Gigahawk/pipod_hw/analysis/usb_differential_impedance.md

# Differential Impedance Calculation for USB Data Signal

Values based on a standard 0.8mm 4 layer board from PCBWay (2116 PrePreg):
https://www.pcbway.com/multi-layer-laminated-structure.html

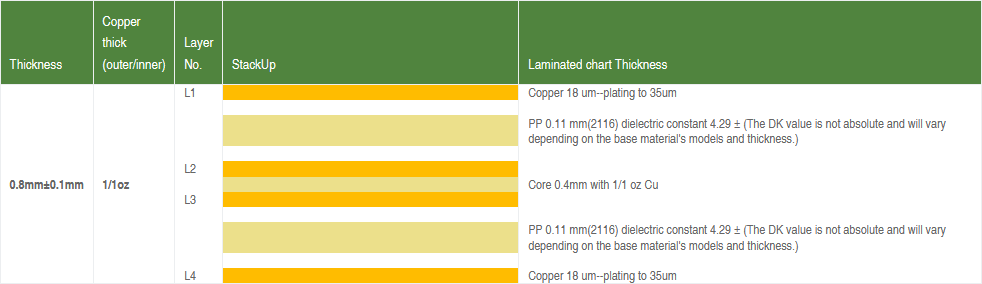
[picture p2: analysis/images/pcbway_stackup.png]
pcbway_stackup


Calculation done using KiCad's impedance caclculator:
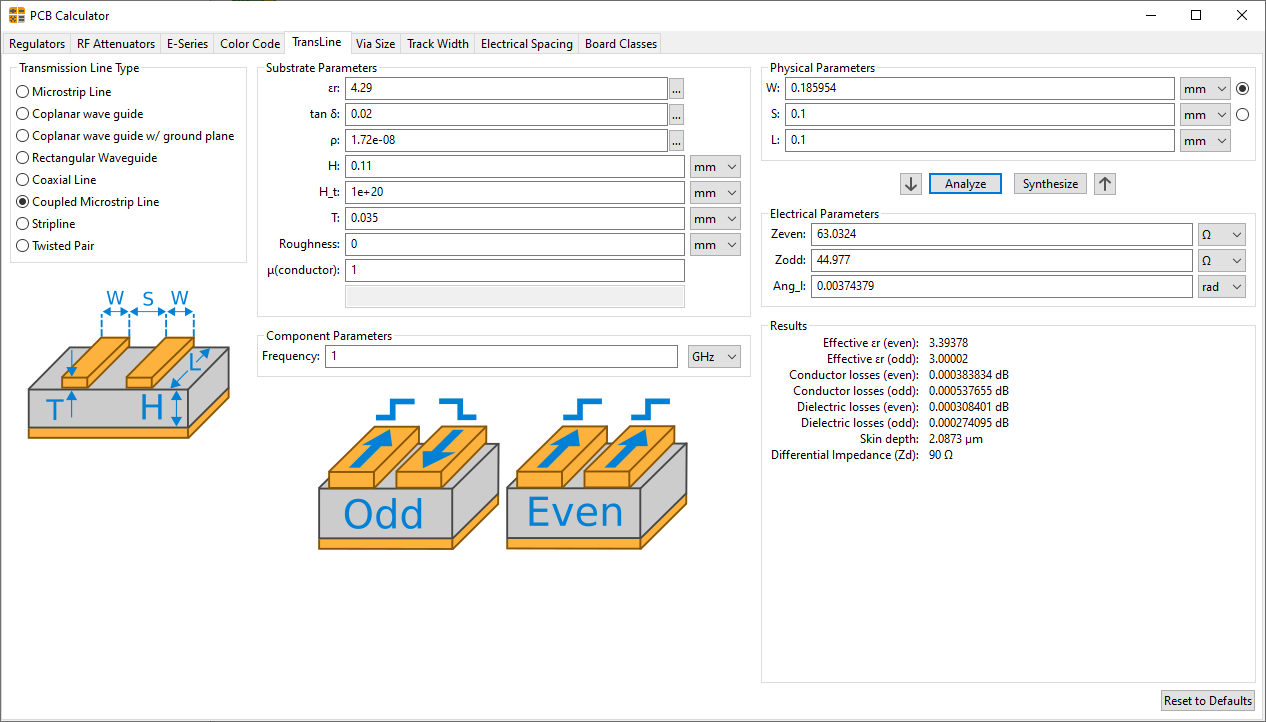
[picture p3: analysis/images/usb_diff_calc_0.1mm_gap.png]
usb_diff_calculations

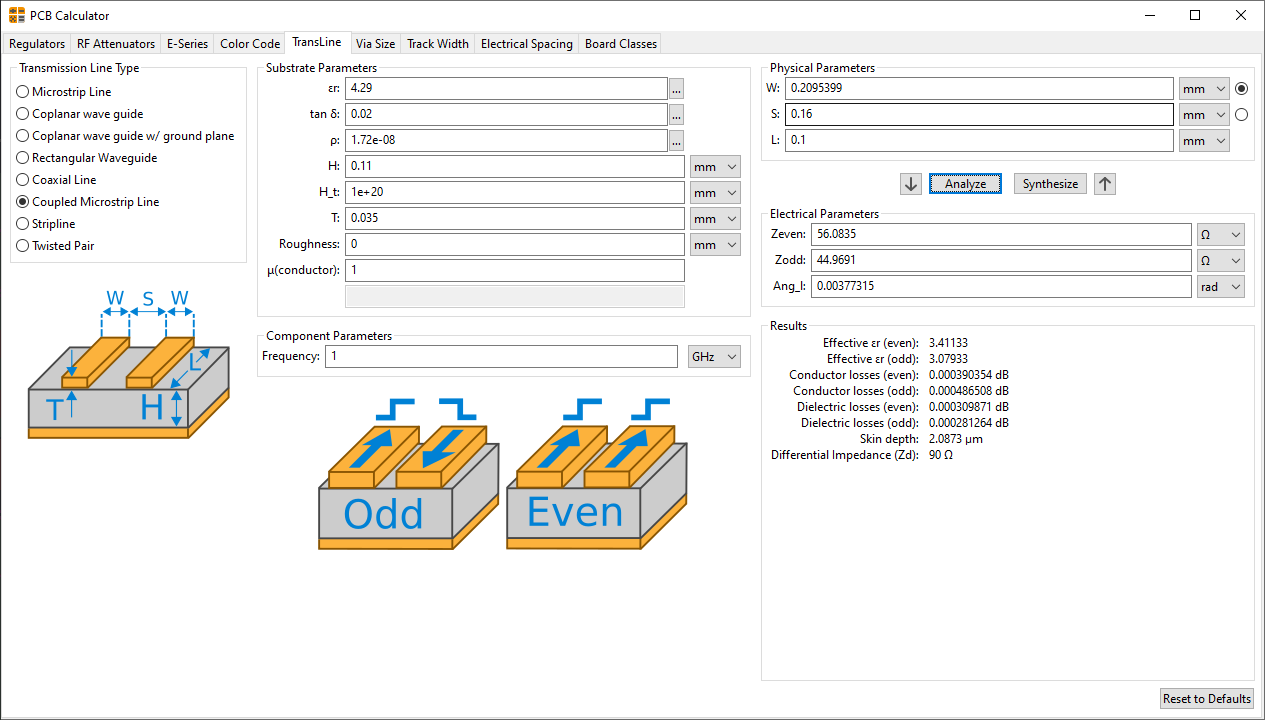
[picture p4: analysis/images/usb_diff_calc_0.16mm_gap.png]
usb_diff_calculations

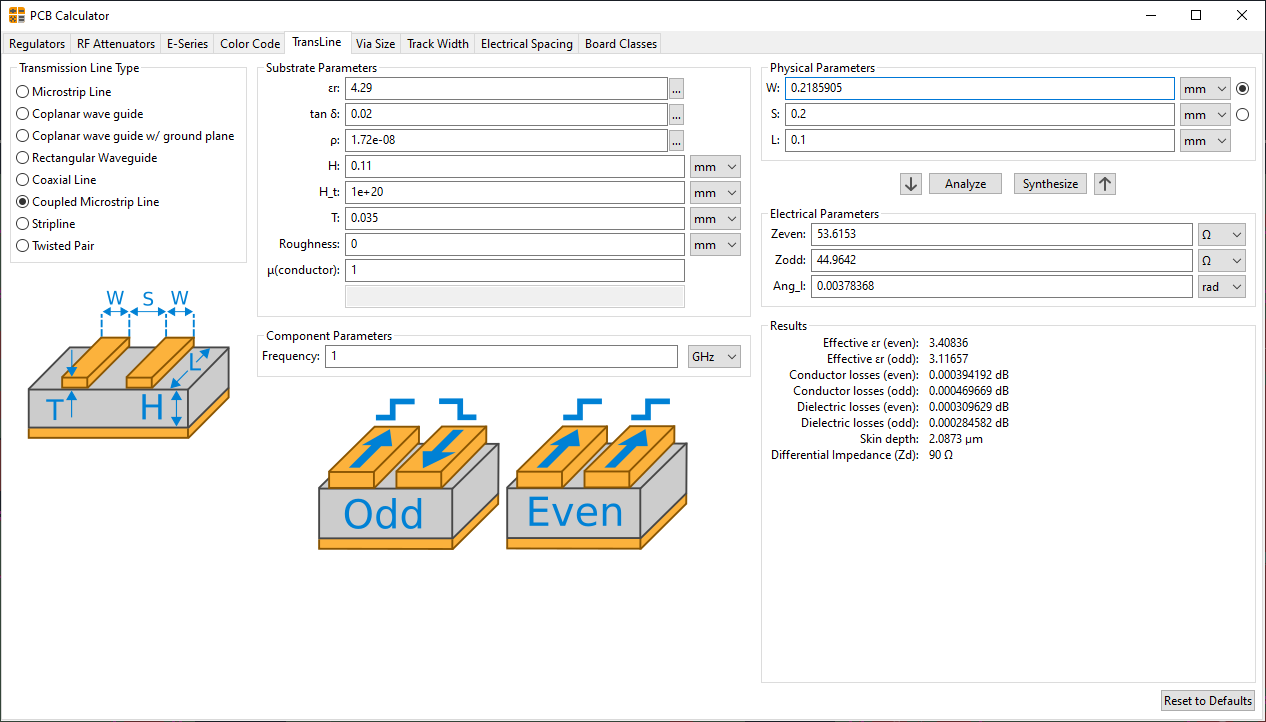
[picture p5: analysis/images/usb_diff_calc_0.2mm_gap.png]
usb_diff_calculations
