Gigahawk/pipod_hw/analysis/vendors.md

# PCB Vendors

While JLCPCB would be preferred for being really cheap, they only allow sourcing parts from LCSC for assembly.
This significantly limits our design freedom.

Instead, we will use PCBWay, since their assembly service allows sourcing parts from anywhere.
