Gigahawk/pipod_hw/(threads)

Thread 1 (2022-09-09):

Display

jaksatomovic, 2022-09-09:
What kind of display do you plan to use. Is it the ipod’s original or something else?

Gigahawk, 2022-09-21:
https://github.com/Gigahawk/pipod_hw/blob/master/analysis/display_mux.md

Closed 2022-09-09.

Thread 3 (2023-02-07):

Random resistor on pi vcc enable?

Gigahawk, 2023-02-07:

Gigahawk, 2023-02-13:
This is probably there so the pi can latch its own power, need to figure out if that's actually implemented

Gigahawk, 2023-02-13:
Yea it's also connected to the gpio expander

Closed 2023-02-13.

Thread 4 (2023-02-07):

Digital pot for charge control?

Gigahawk, 2023-02-07:
Theoretically we can wire the CC lines to the ADC, but will probably have to use some diodes to join them to prevent shorting the lines together.

Need to check what sorts of voltages we expect on the CC lines

Thread 8 (2025-02-08):

Look into using a small MCU to generate mclk?

Gigahawk, 2025-02-08:

Gigahawk, 2025-03-11:
can probably also switch to cirrus logic CS43131, seems to have a integrated headphone driver so we can probably get rid of the separate amp too
