Gigahawk/pipod_hw/pipod_hw.kicad_pcb

## KiCad design pipod_hw.kicad_pcb (2022-12-23)

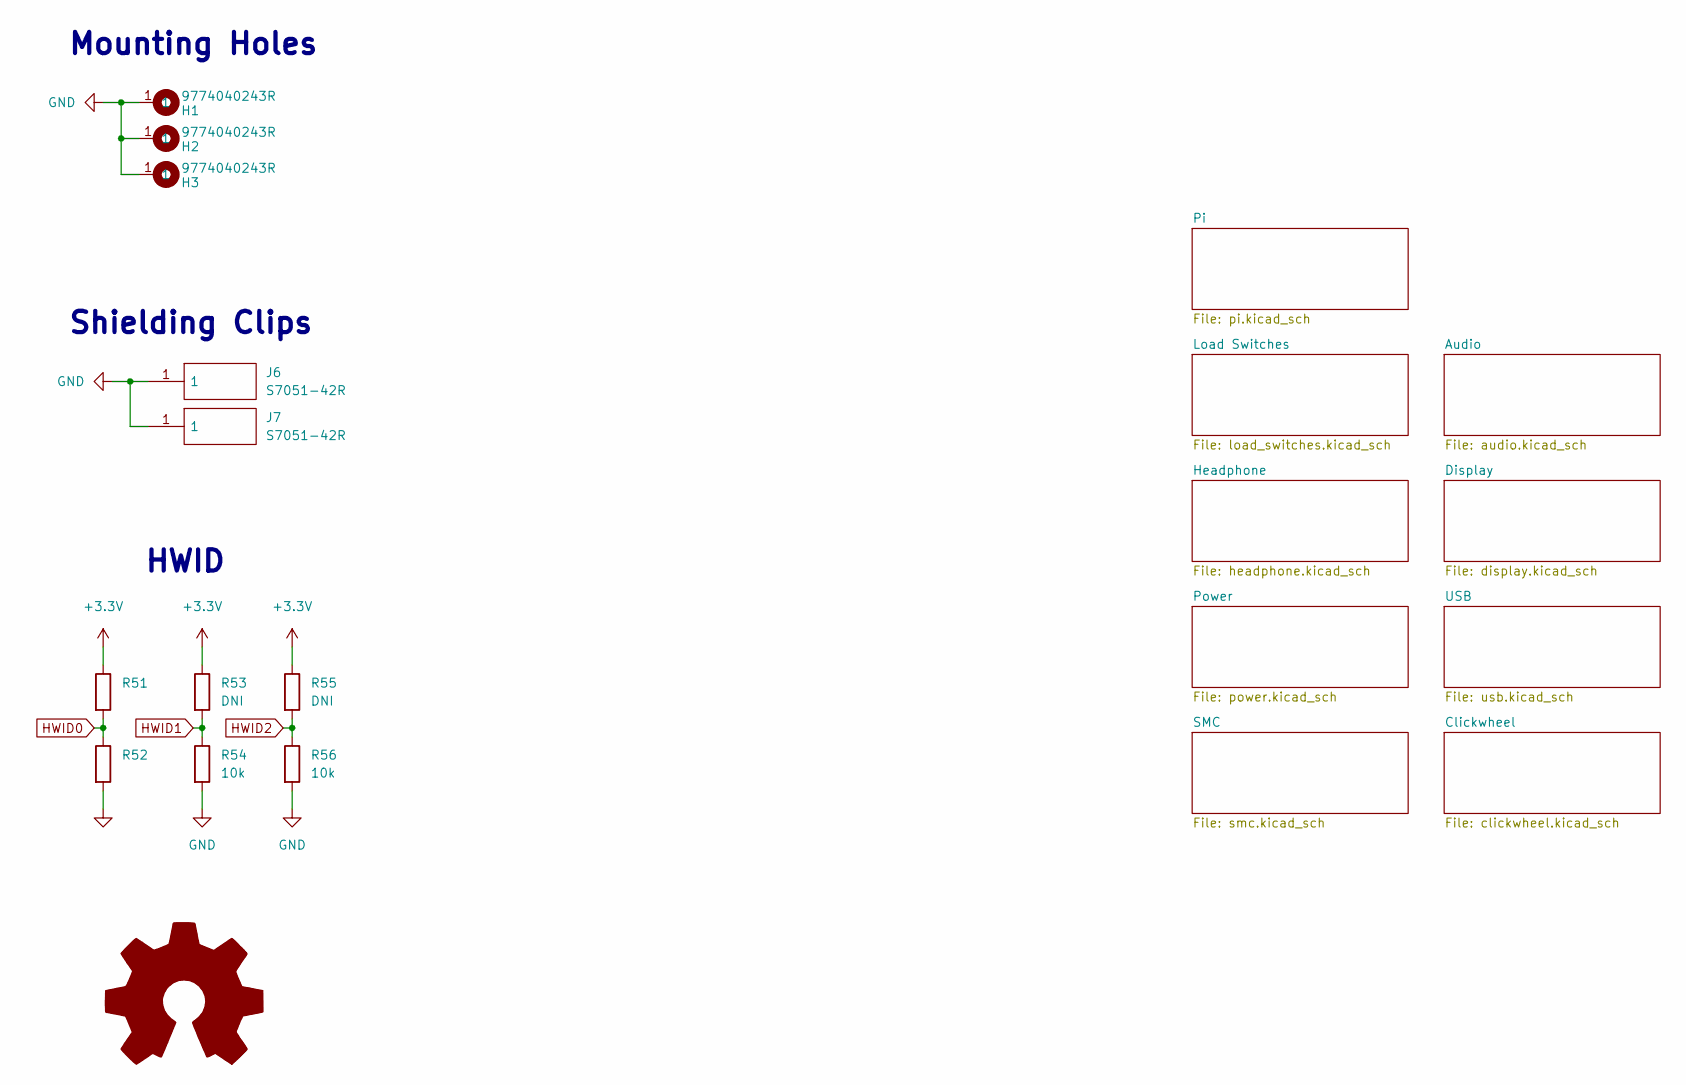
[picture p6: schematic pipod_hw.kicad_sch, piPod IO/SMC Board]

Parts:
H1, H2, H3: 9774040243R; Manufacturer Part 9774040243R; Digikey Part 732-7090-2-ND
J6, J7: S7051-42R; S705142R; Mouser Part 855-S7051-42R
LOGO1: Logo_Open_Hardware_Large; OSHW-Logo2_9.8x8mm_Mask
R51: R_0402_1005Metric
R52: (no value)
R53, R55: DNI; R_0402_1005Metric
R54, R56: 10k; R_0402_1005Metric

Connections:
+3V3: R51.1, R53.1, R55.1; also elsewhere on the board
HWID0: R51.2, R52.1; also elsewhere on the board
HWID1: R53.2, R54.1; also elsewhere on the board
HWID2: R55.2, R56.1; also elsewhere on the board

Notes on the sheet:
Mounting Holes
HWID
Shielding Clips

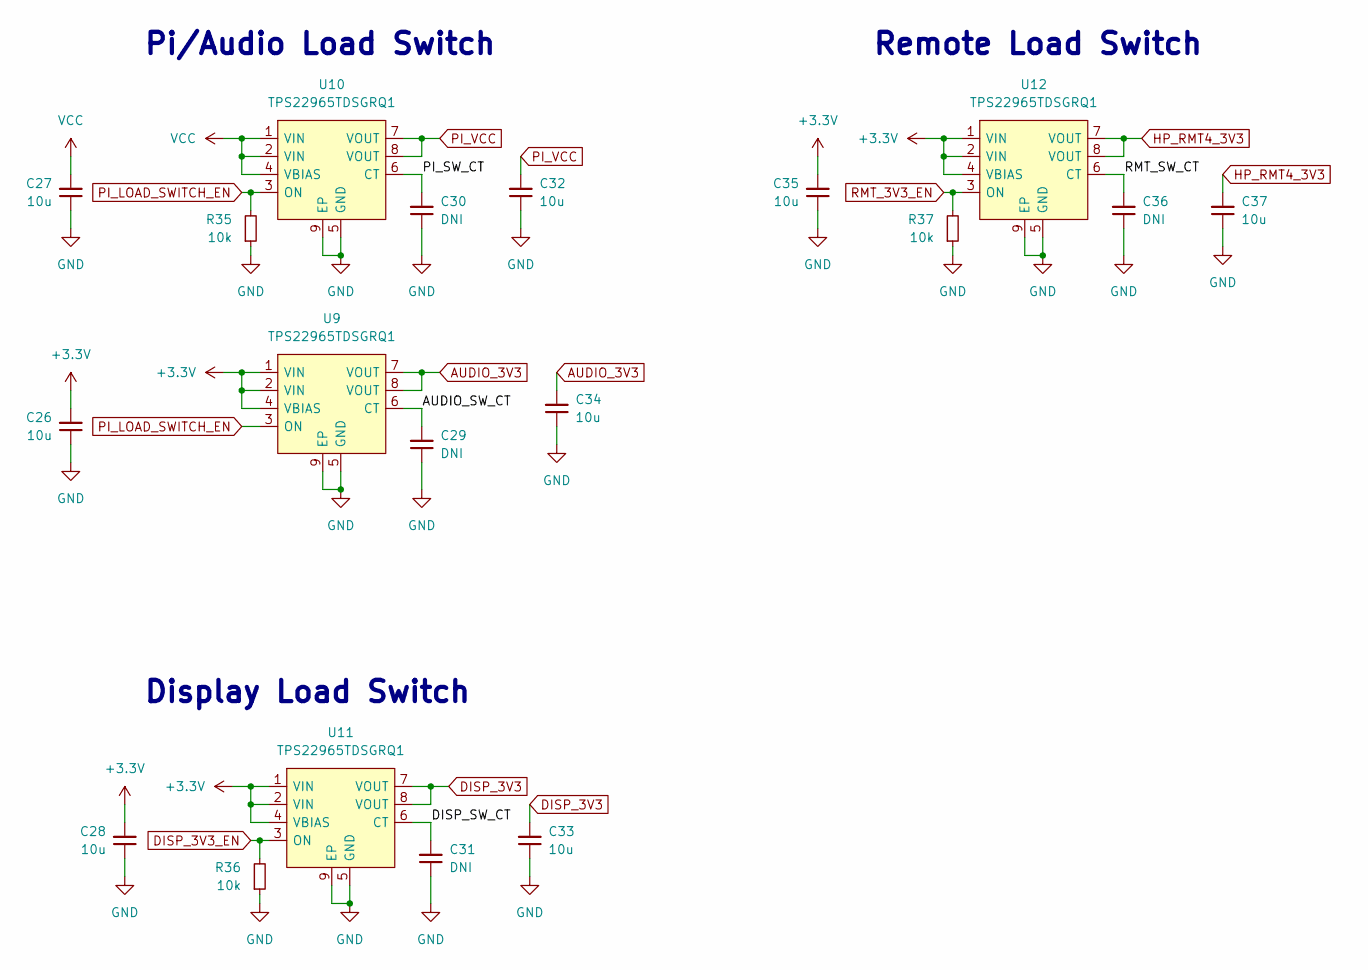
[picture p7: schematic load_switches.kicad_sch, piPod IO/SMC Board]

Parts:
C26, C27, C28, C32, C33, C34, C35, C37: 10u; C_0402_1005Metric
C29, C30, C31, C36: DNI; C_0402_1005Metric
R35, R36, R37: 10k; R_0402_1005Metric
U9, U10, U11, U12: TPS22965TDSGRQ1; WSON-8-1EP_2x2mm_P0.5mm_EP0.9x1.6mm; Manufacturer Part TPS22965TDSGRQ1; Mouser Part 595-TPS22965TDSGRQ1

Connections:
+3V3: C26.2, C28.2, C35.2, U9.1 (VIN), U9.2 (VIN), U9.4 (VBIAS), U11.1 (VIN), U11.2 (VIN), U11.4 (VBIAS), U12.1 (VIN), U12.2 (VIN), U12.4 (VBIAS); also elsewhere on the board
/Load Switches/AUDIO_SW_CT: C29.2, U9.6 (CT)
/Load Switches/DISP_SW_CT: C31.2, U11.6 (CT)
/Load Switches/PI_SW_CT: C30.2, U10.6 (CT)
/Load Switches/RMT_SW_CT: C36.2, U12.6 (CT)
AUDIO_3V3: C34.2, U9.7 (VOUT), U9.8 (VOUT); also elsewhere on the board
DISP_3V3: C33.2, U11.7 (VOUT), U11.8 (VOUT); also elsewhere on the board
DISP_3V3_EN: R36.2, U11.3 (ON); also elsewhere on the board
HP_RMT4_3V3: C37.2, U12.7 (VOUT), U12.8 (VOUT); also elsewhere on the board
PI_LOAD_SWITCH_EN: R35.2, U9.3 (ON), U10.3 (ON); also elsewhere on the board
PI_VCC: C32.2, U10.7 (VOUT), U10.8 (VOUT); also elsewhere on the board
RMT_3V3_EN: R37.2, U12.3 (ON); also elsewhere on the board
VCC: C27.2, U10.1 (VIN), U10.2 (VIN), U10.4 (VBIAS); also elsewhere on the board

Notes on the sheet:
Display Load Switch
Remote Load Switch
Pi/Audio Load Switch

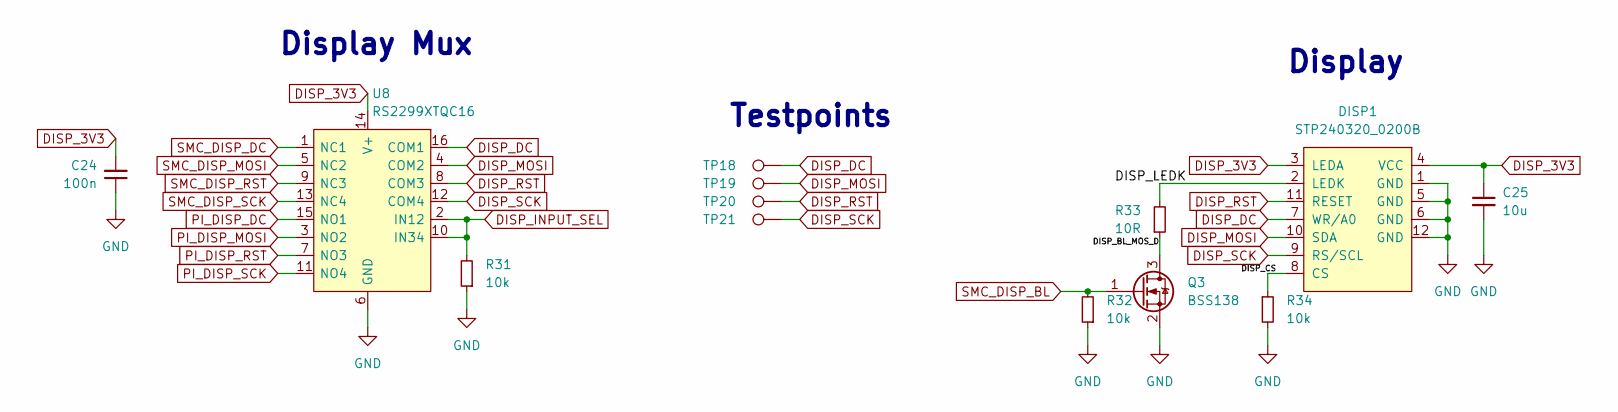
[picture p8: schematic display.kicad_sch, piPod IO/SMC Board]

Parts:
C24: 100n; C_0402_1005Metric
C25: 10u; C_0402_1005Metric
DISP1: STP240320_0200B; Molex_SlimStack_54722-0164_2x08_P0.50mm_Vertical; Manufacturer Part 54722-0164; Digikey Part WM3446TR-ND
Q3: BSS138; SOT-23; Manufacturer Part BSS138; Digikey Part BSS138TR-ND
R31, R32, R34: 10k; R_0402_1005Metric
R33: 10R; R_0402_1005Metric
TP18, TP19, TP20, TP21: TestPoint; TestPoint_Pad_D1.5mm
U8: RS2299XTQC16; QFN-16-1EP_3x3mm_P0.5mm_EP1.7x1.7mm; Manufacturer Part RS2299XTQC16; Digikey Part 3565-RS2299XTQC16TR-ND

Connections:
/Display/DISP_BL_MOS_D: Q3.3 (D), R33.1
/Display/DISP_CS: DISP1.8 (CS), R34.1
/Display/DISP_LEDK: DISP1.2 (LEDK), R33.2
DISP_3V3: C24.2, C25.1, DISP1.3 (LEDA), DISP1.4 (VCC), U8.14 (V+); also elsewhere on the board
DISP_DC: DISP1.7 (WR/A0), TP18.1, U8.16 (COM1)
DISP_INPUT_SEL: R31.2, U8.2 (IN12), U8.10 (IN34); also elsewhere on the board
DISP_MOSI: DISP1.10 (SDA), TP19.1, U8.4 (COM2)
DISP_RST: DISP1.11 (RESET), TP20.1, U8.8 (COM3)
DISP_SCK: DISP1.9 (RS/SCL), TP21.1, U8.12 (COM4)
PI_DISP_DC: U8.15 (NO1); also elsewhere on the board
PI_DISP_MOSI: U8.3 (NO2); also elsewhere on the board
PI_DISP_RST: U8.7 (NO3); also elsewhere on the board
PI_DISP_SCK: U8.11 (NO4); also elsewhere on the board
SMC_DISP_BL: Q3.1 (G), R32.2; also elsewhere on the board
SMC_DISP_DC: U8.1 (NC1); also elsewhere on the board
SMC_DISP_MOSI: U8.5 (NC2); also elsewhere on the board
SMC_DISP_RST: U8.9 (NC3); also elsewhere on the board
SMC_DISP_SCK: U8.13 (NC4); also elsewhere on the board

Notes on the sheet:
Display Mux
Display
Testpoints

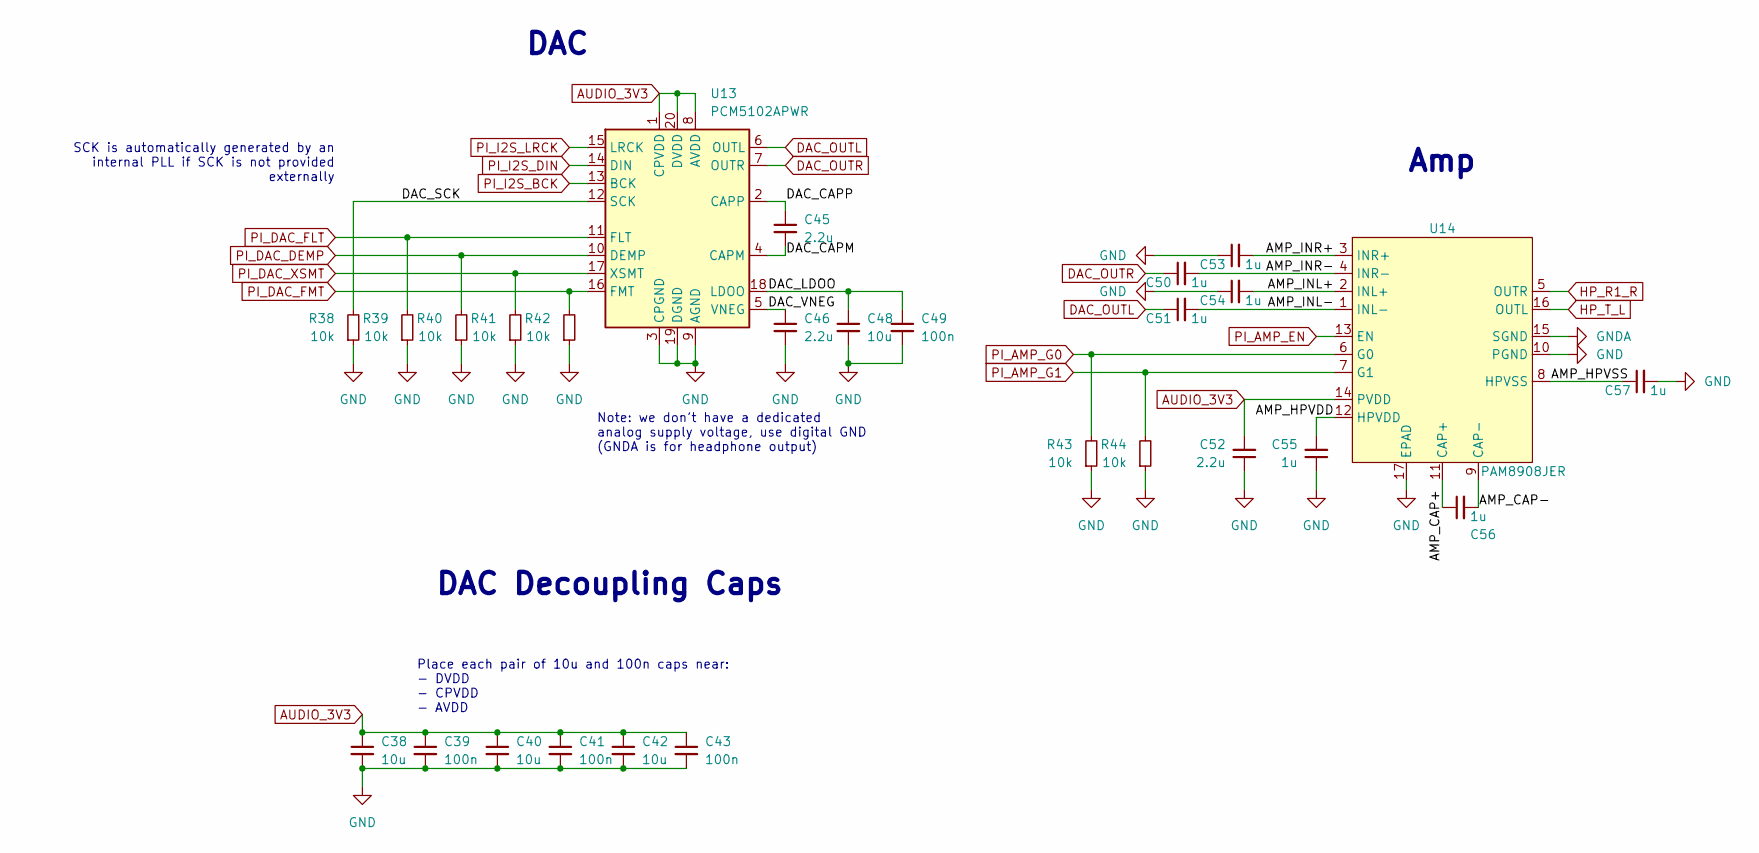
[picture p9: schematic audio.kicad_sch, piPod IO/SMC Board]

Parts:
C38, C40, C42, C48: 10u; C_0402_1005Metric
C39, C41, C43, C49: 100n; C_0402_1005Metric
C45, C46, C52: 2.2u; C_0402_1005Metric
C50, C51, C53, C54, C55, C56, C57: 1u; C_0402_1005Metric
R38, R39, R40, R41, R42, R43, R44: 10k; R_0402_1005Metric
U13: PCM5102APWR; TSSOP-20_4.4x6.5mm_P0.65mm; Manufacturer Part PCM5102APWR; Digikey Part 296-36707-2-ND
U14: PAM8908JER; QFN-16-1EP_3x3mm_P0.5mm_EP1.7x1.7mm; Mouser Part 621-PAM8908JER; LCSC Part C33233

Connections:
/Audio/AMP_CAP+: C56.1, U14.11 (CAP+)
/Audio/AMP_CAP-: C56.2, U14.9 (CAP-)
/Audio/AMP_HPVDD: C55.2, U14.12 (HPVDD)
/Audio/AMP_HPVSS: C57.1, U14.8 (HPVSS)
/Audio/AMP_INL+: C54.2, U14.2 (INL+)
/Audio/AMP_INL-: C51.2, U14.1 (INL-)
/Audio/AMP_INR+: C53.2, U14.3 (INR+)
/Audio/AMP_INR-: C50.2, U14.4 (INR-)
/Audio/DAC_CAPM: C45.2, U13.4 (CAPM)
/Audio/DAC_CAPP: C45.1, U13.2 (CAPP)
/Audio/DAC_LDOO: C48.1, C49.1, U13.18 (LDOO)
/Audio/DAC_SCK: R38.2, U13.12 (SCK)
/Audio/DAC_VNEG: C46.1, U13.5 (VNEG)
AUDIO_3V3: C38.1, C39.1, C40.1, C41.1, C42.1, C43.1, C52.2, U13.1 (CPVDD), U13.8 (AVDD), U13.20 (DVDD), U14.14 (PVDD); also elsewhere on the board
DAC_OUTL: C51.1, U13.6 (OUTL)
DAC_OUTR: C50.1, U13.7 (OUTR)
GNDA: U14.15 (SGND); also elsewhere on the board
HP_R1_R: U14.5 (OUTR); also elsewhere on the board
HP_T_L: U14.16 (OUTL); also elsewhere on the board
PI_AMP_EN: U14.13 (EN); also elsewhere on the board
PI_AMP_G0: R43.2, U14.6 (G0); also elsewhere on the board
PI_AMP_G1: R44.2, U14.7 (G1); also elsewhere on the board
PI_DAC_DEMP: R40.2, U13.10 (DEMP); also elsewhere on the board
PI_DAC_FLT: R39.2, U13.11 (FLT); also elsewhere on the board
PI_DAC_FMT: R42.2, U13.16 (FMT); also elsewhere on the board
PI_DAC_XSMT: R41.2, U13.17 (XSMT); also elsewhere on the board
PI_I2S_BCK: U13.13 (BCK); also elsewhere on the board
PI_I2S_DIN: U13.14 (DIN); also elsewhere on the board
PI_I2S_LRCK: U13.15 (LRCK); also elsewhere on the board

Notes on the sheet:
Note: we don't have a dedicated analog supply voltage, use digital GND (GNDA is for headphone output)
Amp
Place each pair of 10u and 100n caps near: - DVDD - CPVDD - AVDD
DAC Decoupling Caps
SCK is automatically generated by an internal PLL if SCK is not provided externally
DAC

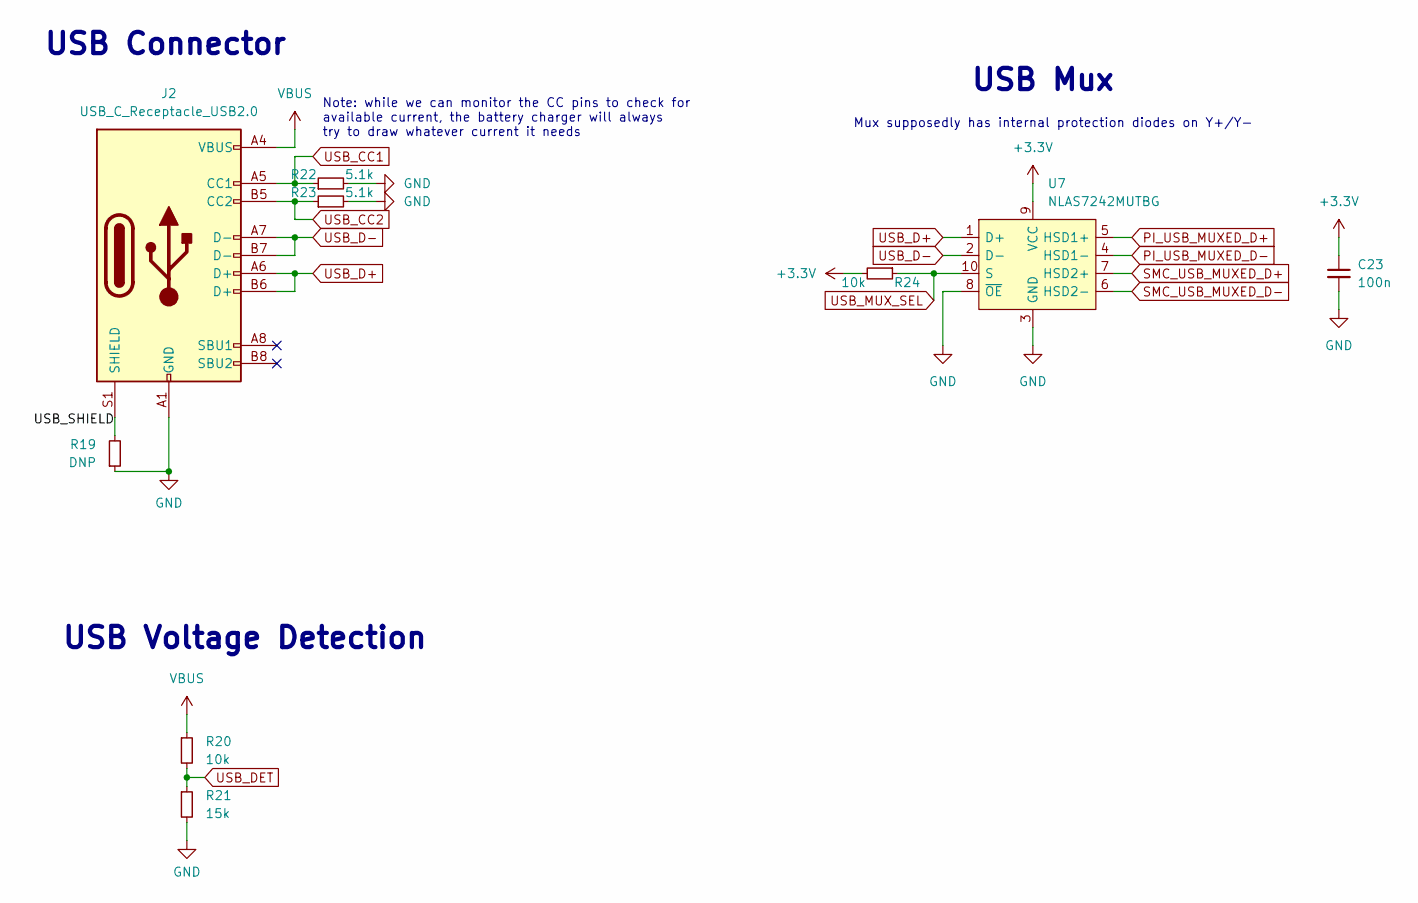
[picture p10: schematic usb.kicad_sch, piPod IO/SMC Board]

Parts:
C23: 100n; C_0402_1005Metric
J2: USB_C_Receptacle_USB2.0; USB_C_Receptacle_GCT_USB4085; Manufacturer Part USB4085-GF-A; Digikey Part 2073-USB4085-GF-ATR-ND
R19: DNP; R_0402_1005Metric
R20, R24: 10k; R_0402_1005Metric
R21: 15k; R_0402_1005Metric
R22, R23: 5.1k; R_0402_1005Metric
U7: NLAS7242MUTBG; UQFN-10_1.4x1.8mm_P0.4mm; Manufacturer Part NLAS7242MUTBG; Mouser Part 863-NLAS7242MUTBG

Connections:
+3V3: C23.1, R24.2, U7.9 (VCC); also elsewhere on the board
/USB/USB_SHIELD: J2.S1 (SHIELD), R19.2
PI_USB_MUXED_D+: U7.5 (HSD1+); also elsewhere on the board
PI_USB_MUXED_D-: U7.4 (HSD1-); also elsewhere on the board
SMC_USB_MUXED_D+: U7.7 (HSD2+); also elsewhere on the board
SMC_USB_MUXED_D-: U7.6 (HSD2-); also elsewhere on the board
USB_CC1: J2.A5 (CC1), R22.1
USB_CC2: J2.B5 (CC2), R23.1
USB_D+: J2.A6 (D+), J2.B6 (D+), U7.1 (D+)
USB_D-: J2.A7 (D-), J2.B7 (D-), U7.2 (D-)
USB_DET: R20.2, R21.1; also elsewhere on the board
USB_MUX_SEL: R24.1, U7.10 (S); also elsewhere on the board
VBUS: J2.A4 (VBUS), J2.A9 (VBUS), J2.B4 (VBUS), J2.B9 (VBUS), R20.1; also elsewhere on the board

Notes on the sheet:
USB Mux
USB Voltage Detection
Note: while we can monitor the CC pins to check for available current, the battery charger will always try to draw whatever current it needs
USB Connector
Mux supposedly has internal protection diodes on Y+/Y-

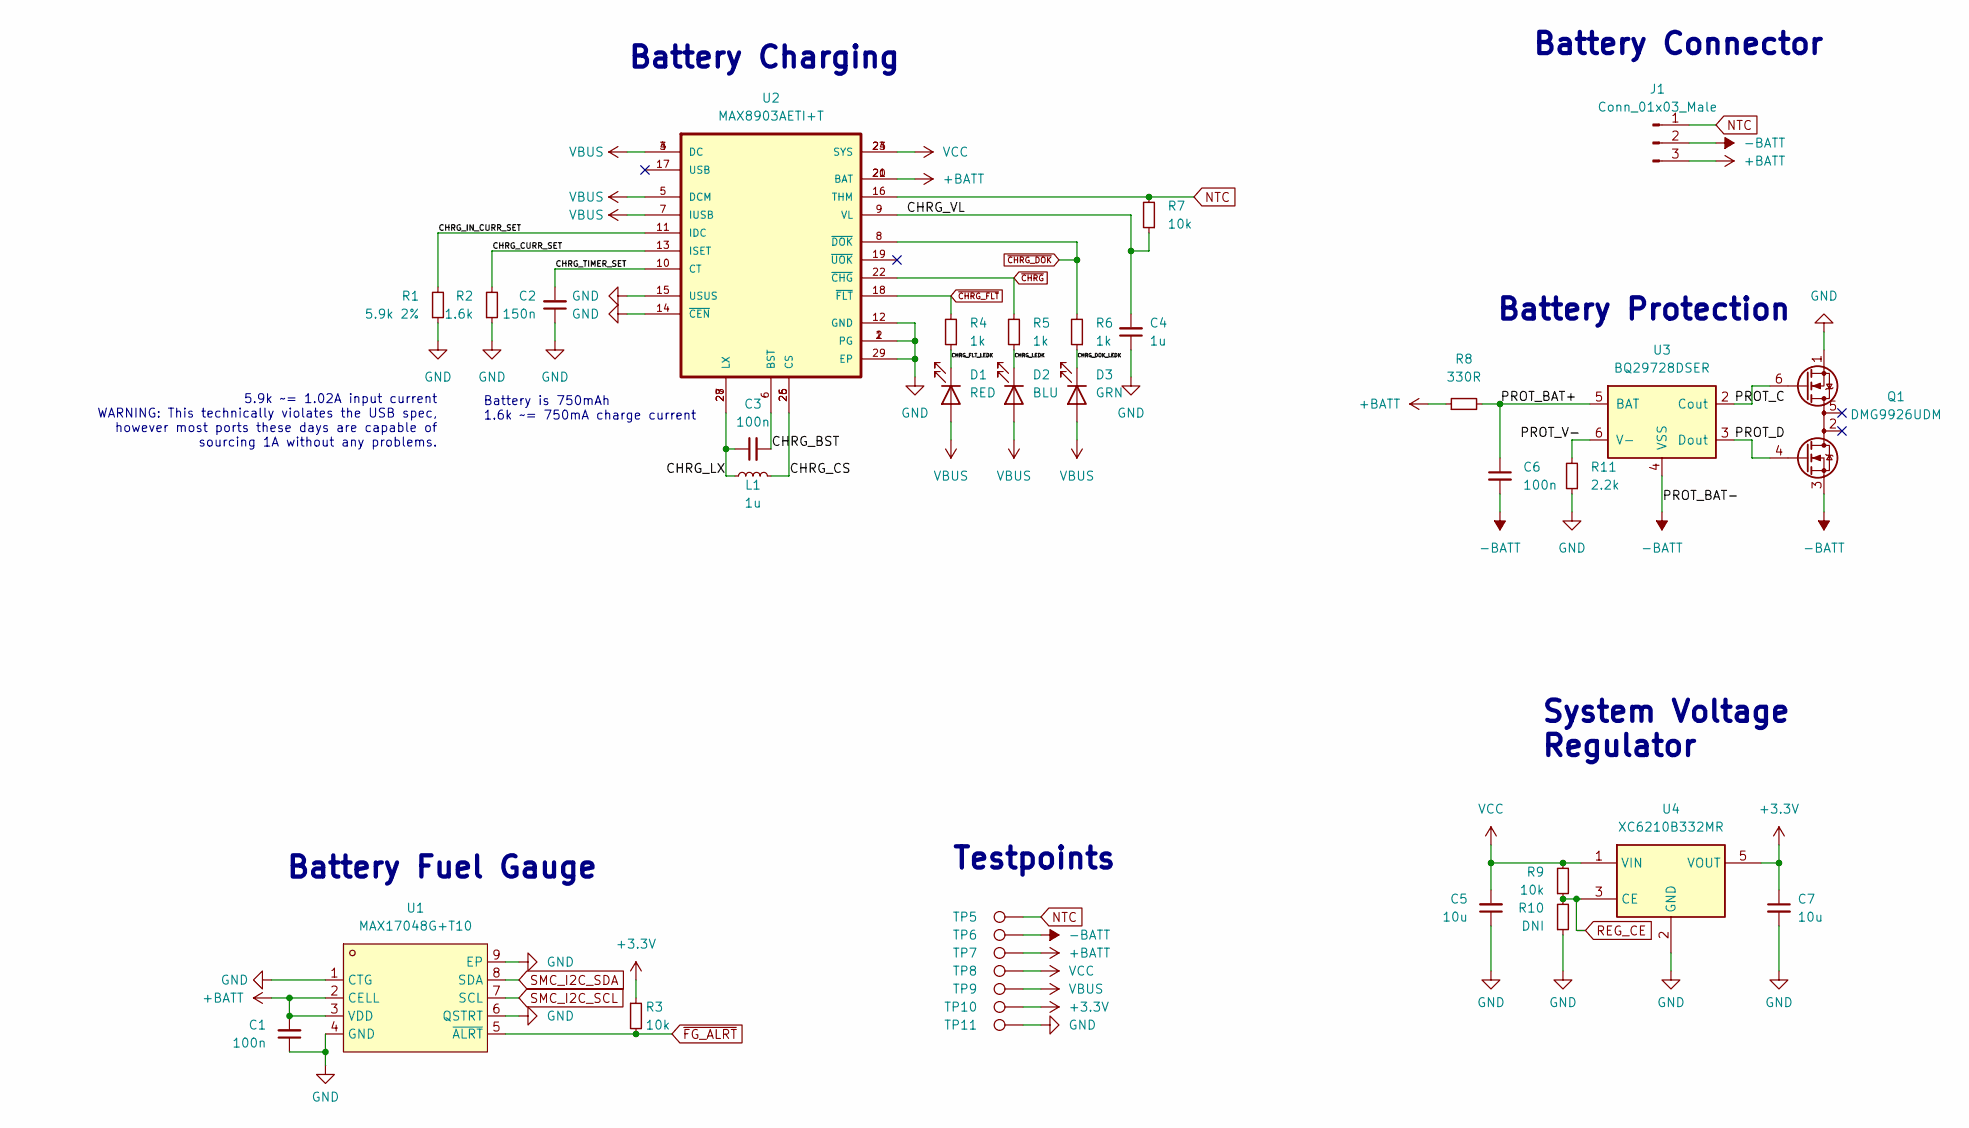
[picture p11: schematic power.kicad_sch, piPod IO/SMC Board]

Parts:
C1, C3, C6: 100n; C_0402_1005Metric
C2: 150n; C_0402_1005Metric
C4: 1u; C_0402_1005Metric
C5, C7: 10u; C_0402_1005Metric
D1: RED; LED_0402_1005Metric
D2: BLU; LED_0402_1005Metric
D3: GRN; LED_0402_1005Metric
J1: Conn_01x03_Male; Molex_PicoBlade_53047-0310_1x03_P1.25mm_Vertical; Manufacturer Part 0530470310; Digikey Part WM1732-ND
L1: 1u; L_Vishay_IFSC-1515AH_4x4x1.8mm; Manufacturer Part IFSC1515AHER2R2M01; Digikey Part 541-1404-2-ND
Q1: DMG9926UDM; SOT-23-6; Manufacturer Part DMG9926UDM-7; Digikey Part DMG9926UDMDITR-ND
R1: 5.9k 2%; R_0402_1005Metric
R2: 1.6k; R_0402_1005Metric
R3, R7, R9: 10k; R_0402_1005Metric
R4, R5, R6: 1k; R_0402_1005Metric
R8: 330R; R_0402_1005Metric
R10: DNI; R_0402_1005Metric
R11: 2.2k; R_0402_1005Metric
TP5, TP6, TP7, TP8, TP9, TP10, TP11: TestPoint; TestPoint_Pad_D1.5mm
U1: MAX17048G+T10; DFN-8-1EP_2x2mm_P0.5mm_EP0.6x1.2mm; Manufacturer Part MAX17048G+T10; LCSC Part C2682616
U2: MAX8903AETI+T; QFN-28-1EP_4x4mm_P0.4mm_EP2.6x2.6mm; Manufacturer Part MAX8903AETI+T; Digikey Part MAX8903AETI+TTR-ND
U3: BQ29728DSER; WSON-6_1.5x1.5mm_P0.5mm; Manufacturer Part BQ29728DSER; Digikey Part 296-BQ29728DSERTR-ND
U4: XC6210B332MR; SOT-23-5; Manufacturer Part XC6210B332MR-G; Digikey Part 893-1075-2-ND

Connections:
+3V3: C7.1, R3.1, TP10.1, U4.5 (VOUT); also elsewhere on the board
+BATT: C1.2, J1.3, R8.1, TP7.1, U1.2 (CELL), U1.3 (VDD), U2.20 (BAT), U2.21 (BAT)
-BATT: C6.2, J1.2, Q1.3 (S2), TP6.1, U3.4 (VSS)
/Power/CHRG_BST: C3.2, U2.6 (BST)
/Power/CHRG_CS: L1.1, U2.25 (CS), U2.26 (CS)
/Power/CHRG_CURR_SET: R2.2, U2.13 (ISET)
/Power/CHRG_DOK_LEDK: D3.1 (K), R6.1
/Power/CHRG_FLT_LEDK: D1.1 (K), R4.1
/Power/CHRG_IN_CURR_SET: R1.2, U2.11 (IDC)
/Power/CHRG_LEDK: D2.1 (K), R5.1
/Power/CHRG_LX: C3.1, L1.2, U2.27 (LX), U2.28 (LX)
/Power/CHRG_TIMER_SET: C2.2, U2.10 (CT)
/Power/CHRG_VL: C4.2, R7.1, U2.9 (VL)
/Power/PROT_BAT+: C6.1, R8.2, U3.5 (BAT)
/Power/PROT_C: Q1.6 (G1), U3.2 (Cout)
/Power/PROT_D: Q1.4 (G2), U3.3 (Dout)
/Power/PROT_V-: R11.2, U3.6 (V-)
NTC: J1.1, R7.2, TP5.1, U2.16 (THM)
REG_CE: R9.1, R10.2, U4.3 (CE)
SMC_I2C_SCL: U1.7 (SCL); also elsewhere on the board
SMC_I2C_SDA: U1.8 (SDA); also elsewhere on the board
VBUS: D1.2 (A), D2.2 (A), D3.2 (A), TP9.1, U2.3 (DC), U2.4 (DC), U2.5 (DCM), U2.7 (IUSB); also elsewhere on the board
VCC: C5.2, R9.2, TP8.1, U2.23 (SYS), U2.24 (SYS), U4.1 (VIN); also elsewhere on the board
~CHRG_DOK: R6.2, U2.8 (~DOK)
~CHRG_FLT: R4.2, U2.18 (~FLT)
~CHRG: R5.2, U2.22 (~CHG)
~FG_ALRT: R3.2, U1.5 (~ALRT); also elsewhere on the board

Notes on the sheet:
Testpoints
Battery is 750mAh 1.6k ~= 750mA charge current
Battery Connector
Battery Fuel Gauge
Battery Charging
5.9k ~= 1.02A input current WARNING: This technically violates the USB spec, however most ports these days are capable of sourcing 1A without any problems.
System Voltage Regulator
Battery Protection

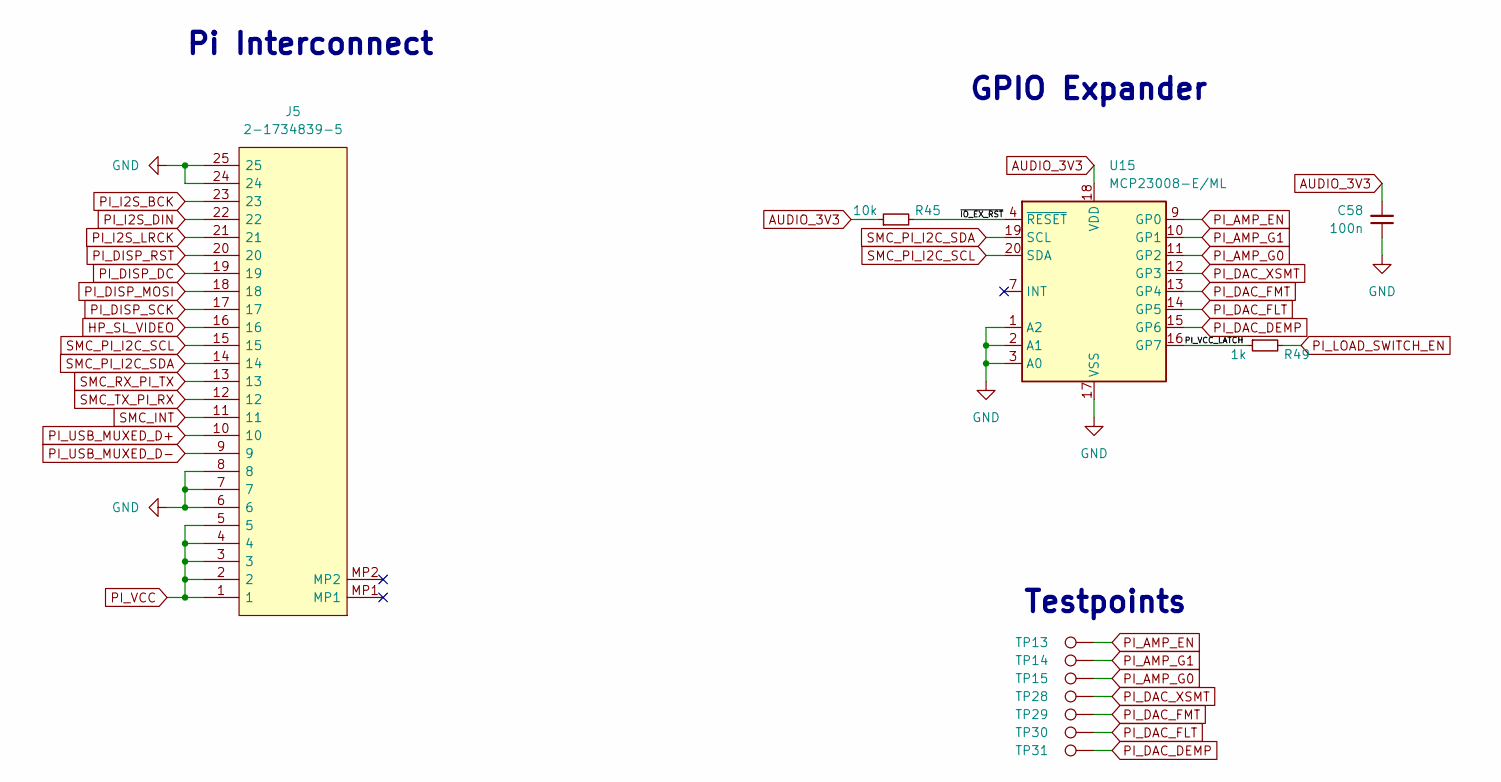
[picture p12: schematic pi.kicad_sch, piPod IO/SMC Board]

Parts:
C58: 100n; C_0402_1005Metric
J5: 2-1734839-5; 217348395; Mouser Part 571-2-1734839-5
R45: 10k; R_0402_1005Metric
R49: 1k; R_0402_1005Metric
TP13, TP14, TP15, TP28, TP29, TP30, TP31: TestPoint; TestPoint_Pad_D1.5mm
U15: MCP23008-E/ML; QFN-20-1EP_4x4mm_P0.5mm_EP2.7x2.7mm; Manufacturer Part MCP23008-E/ML; Digikey Part MCP23008-E/ML-ND

Connections:
/Pi/PI_VCC_LATCH: R49.1, U15.16 (GP7)
/Pi/~IO_EX_RST: R45.2, U15.4 (~RESET)
AUDIO_3V3: C58.2, R45.1, U15.18 (VDD); also elsewhere on the board
HP_SL_VIDEO: J5.16; also elsewhere on the board
PI_AMP_EN: TP13.1, U15.9 (GP0); also elsewhere on the board
PI_AMP_G0: TP15.1, U15.11 (GP2); also elsewhere on the board
PI_AMP_G1: TP14.1, U15.10 (GP1); also elsewhere on the board
PI_DAC_DEMP: TP31.1, U15.15 (GP6); also elsewhere on the board
PI_DAC_FLT: TP30.1, U15.14 (GP5); also elsewhere on the board
PI_DAC_FMT: TP29.1, U15.13 (GP4); also elsewhere on the board
PI_DAC_XSMT: TP28.1, U15.12 (GP3); also elsewhere on the board
PI_DISP_DC: J5.19; also elsewhere on the board
PI_DISP_MOSI: J5.18; also elsewhere on the board
PI_DISP_RST: J5.20; also elsewhere on the board
PI_DISP_SCK: J5.17; also elsewhere on the board
PI_I2S_BCK: J5.23; also elsewhere on the board
PI_I2S_DIN: J5.22; also elsewhere on the board
PI_I2S_LRCK: J5.21; also elsewhere on the board
PI_LOAD_SWITCH_EN: R49.2; also elsewhere on the board
PI_USB_MUXED_D+: J5.10; also elsewhere on the board
PI_USB_MUXED_D-: J5.9; also elsewhere on the board
PI_VCC: J5.1, J5.2, J5.3, J5.4, J5.5; also elsewhere on the board
SMC_INT: J5.11; also elsewhere on the board
SMC_PI_I2C_SCL: J5.15, U15.20 (SDA); also elsewhere on the board
SMC_PI_I2C_SDA: J5.14, U15.19 (SCL); also elsewhere on the board
SMC_RX_PI_TX: J5.13; also elsewhere on the board
SMC_TX_PI_RX: J5.12; also elsewhere on the board

Notes on the sheet:
GPIO Expander
Testpoints
Pi Interconnect

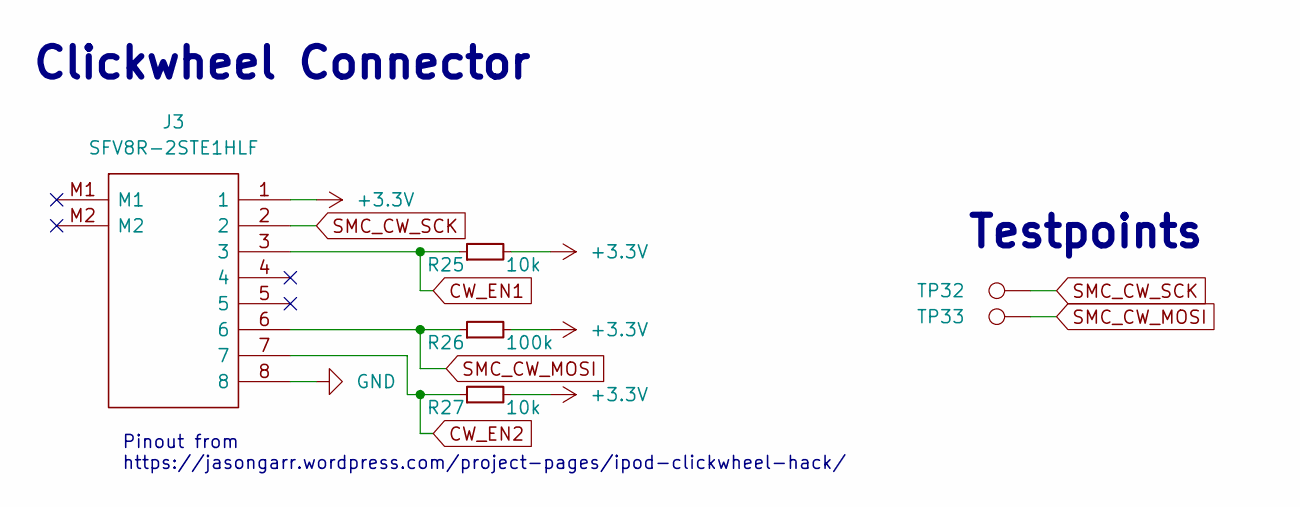
[picture p13: schematic clickwheel.kicad_sch, piPod IO/SMC Board]

Parts:
J3: SFV8R-2STE1HLF; SFV8R2STE1HLF; Mouser Part 649-SFV8R-2STE1HLF
R25, R27: 10k; R_0402_1005Metric
R26: 100k; R_0402_1005Metric
TP32, TP33: TestPoint; TestPoint_Pad_D1.5mm

Connections:
+3V3: J3.1, R25.2, R26.2, R27.2; also elsewhere on the board
CW_EN1: J3.3, R25.1
CW_EN2: J3.7, R27.1
SMC_CW_MOSI: J3.6, R26.1, TP33.1; also elsewhere on the board
SMC_CW_SCK: J3.2, TP32.1; also elsewhere on the board

Notes on the sheet:
Clickwheel Connector
Testpoints
Pinout from https://jasongarr.wordpress.com/project-pages/ipod-clickwheel-hack/

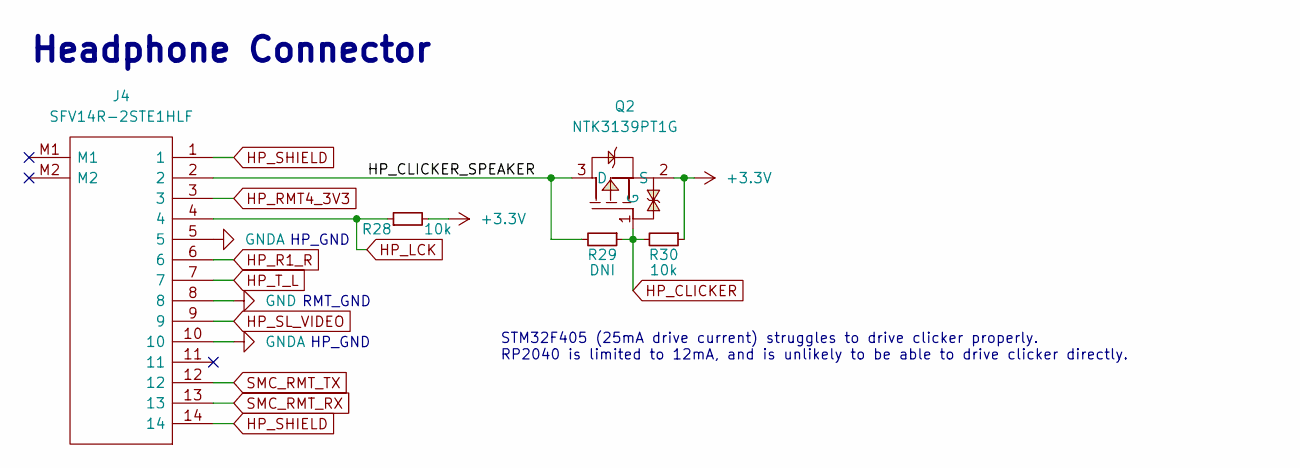
[picture p14: schematic headphone.kicad_sch, piPod IO/SMC Board]

Parts:
J4: SFV14R-2STE1HLF; SFV14R2STE1HLF; Manufacturer Part SFV14R-2STE1HLF; Mouser Part 649-SFV14R-2STE1HLF
Q2: NTK3139PT1G; SOT-723; Manufacturer Part NTK3139PT1G; LCSC Part C236246
R28, R30: 10k; R_0402_1005Metric
R29: DNI; R_0402_1005Metric

Connections:
+3V3: Q2.2 (S), R28.2, R30.1; also elsewhere on the board
/Headphone/HP_CLICKER_SPEAKER: J4.2, Q2.3 (D), R29.2
GNDA: J4.5, J4.10; also elsewhere on the board
HP_CLICKER: Q2.1 (G), R29.1, R30.2; also elsewhere on the board
HP_LCK: J4.4, R28.1; also elsewhere on the board
HP_R1_R: J4.6; also elsewhere on the board
HP_RMT4_3V3: J4.3; also elsewhere on the board
HP_SHIELD: J4.1, J4.14
HP_SL_VIDEO: J4.9; also elsewhere on the board
HP_T_L: J4.7; also elsewhere on the board
SMC_RMT_RX: J4.13; also elsewhere on the board
SMC_RMT_TX: J4.12; also elsewhere on the board

Notes on the sheet:
RMT_GND
Headphone Connector
STM32F405 (25mA drive current) struggles to drive clicker properly. RP2040 is limited to 12mA, and is unlikely to be able to drive clicker directly.
HP_GND
