Gigahawk/pipod_hw/pipod_hw.kicad_pcb

## KiCad design pipod_hw.kicad_pcb (continued)

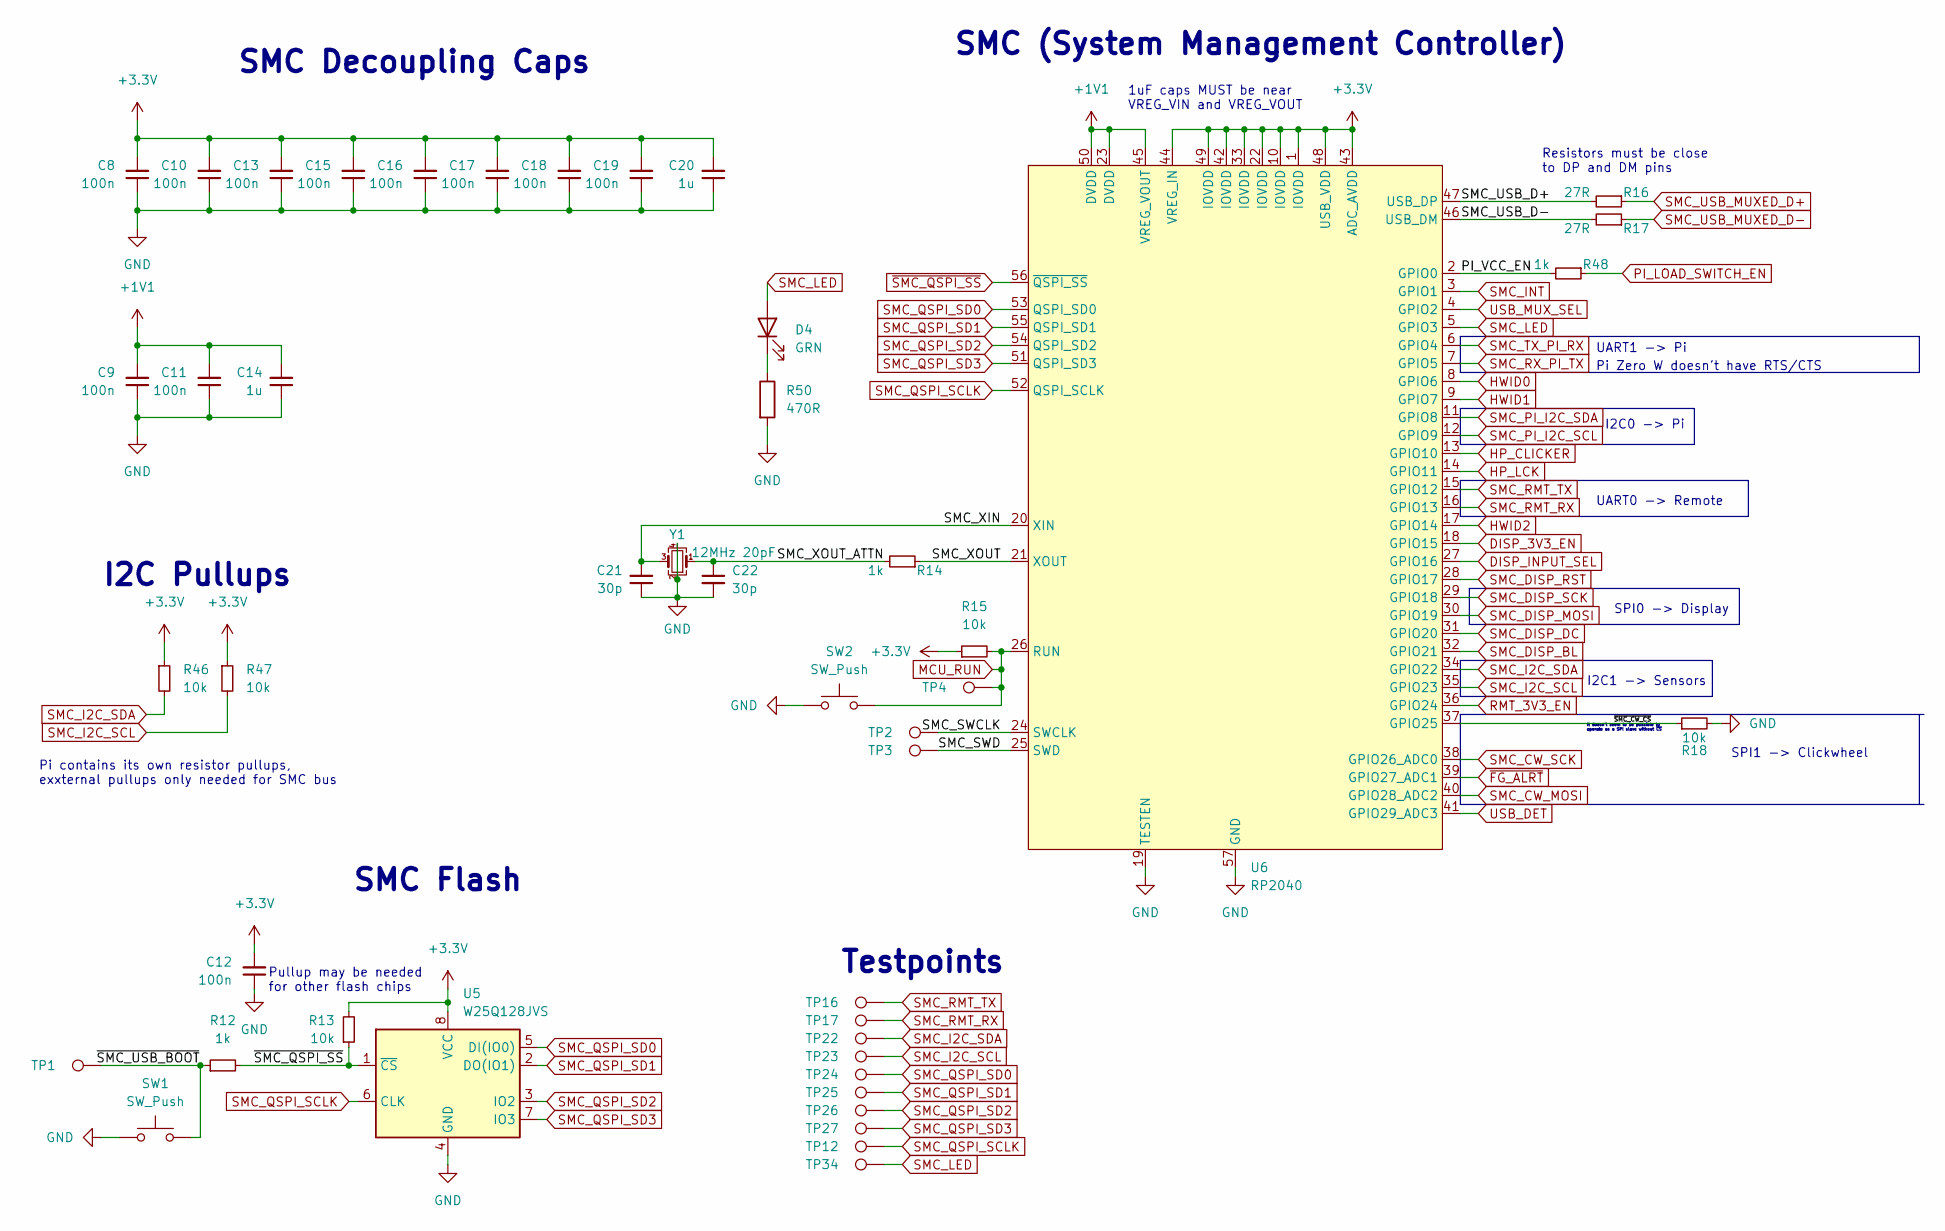
[picture p15: schematic smc.kicad_sch, piPod IO/SMC Board]

Parts:
C8, C9, C10, C11, C12, C13, C15, C16, C17, C18, C19: 100n; C_0402_1005Metric
C14, C20: 1u; C_0402_1005Metric
C21, C22: 30p; C_0402_1005Metric
D4: GRN; LED_0402_1005Metric
R12, R14, R48: 1k; R_0402_1005Metric
R13, R15, R18, R46, R47: 10k; R_0402_1005Metric
R16, R17: 27R; R_0402_1005Metric
R50: 470R; R_0402_1005Metric
SW1, SW2: SW_Push; SW_Push_1P1T_NO_CK_KMR2
TP1, TP2, TP3, TP4, TP12, TP16, TP17, TP22, TP23, TP24, TP25, TP26, TP27, TP34: TestPoint; TestPoint_Pad_D1.5mm
U5: W25Q128JVS; WSON-8-1EP_6x5mm_P1.27mm_EP3.4x4.3mm; Manufacturer Part W25Q128JVS; Digikey Part W25Q128JVSIMTR-ND
U6: RP2040; QFN-56-1EP_7x7mm_P0.4mm_EP5.6x5.6mm; Manufacturer Part RP2040; LCSC Part C2040
Y1: 12MHz 20pF; Crystal_SMD_2520-4Pin_2.5x2.0mm; Manufacturer Part FH1200001; LCSC Part C1985748

Connections:
+1V1: C9.2, C11.2, C14.2, U6.23 (DVDD), U6.45 (VREG_VOUT), U6.50 (DVDD)
+3V3: C8.2, C10.2, C12.2, C13.2, C15.2, C16.2, C17.2, C18.2, C19.2, C20.2, R13.2, R15.1, R46.1, R47.1, U5.8 (VCC), U6.1 (IOVDD), U6.10 (IOVDD), U6.22 (IOVDD), U6.33 (IOVDD), U6.42 (IOVDD), U6.43 (ADC_AVDD), U6.44 (VREG_IN), U6.48 (USB_VDD), U6.49 (IOVDD); also elsewhere on the board
/SMC/PI_VCC_EN: R48.2, U6.2 (GPIO0)
/SMC/SMC_SWCLK: TP2.1, U6.24 (SWCLK)
/SMC/SMC_SWD: TP3.1, U6.25 (SWD)
/SMC/SMC_USB_D+: R16.2, U6.47 (USB_DP)
/SMC/SMC_USB_D-: R17.2, U6.46 (USB_DM)
/SMC/SMC_XIN: C21.2, U6.20 (XIN), Y1.3
/SMC/SMC_XOUT: R14.1, U6.21 (XOUT)
/SMC/SMC_XOUT_ATTN: C22.1, R14.2, Y1.1
/SMC/~SMC_CW_CS: R18.1, U6.37 (GPIO25)
/SMC/~SMC_USB_BOOT: R12.1, SW1.2, TP1.1
DISP_3V3_EN: U6.18 (GPIO15); also elsewhere on the board
DISP_INPUT_SEL: U6.27 (GPIO16); also elsewhere on the board
HP_CLICKER: U6.13 (GPIO10); also elsewhere on the board
HP_LCK: U6.14 (GPIO11); also elsewhere on the board
HWID0: U6.8 (GPIO6); also elsewhere on the board
HWID1: U6.9 (GPIO7); also elsewhere on the board
HWID2: U6.17 (GPIO14); also elsewhere on the board
MCU_RUN: R15.2, SW2.2, TP4.1, U6.26 (RUN)
unnamed: D4.1 (K), R50.1
PI_LOAD_SWITCH_EN: R48.1; also elsewhere on the board
RMT_3V3_EN: U6.36 (GPIO24); also elsewhere on the board
SMC_CW_MOSI: U6.40 (GPIO28_ADC2); also elsewhere on the board
SMC_CW_SCK: U6.38 (GPIO26_ADC0); also elsewhere on the board
SMC_DISP_BL: U6.32 (GPIO21); also elsewhere on the board
SMC_DISP_DC: U6.31 (GPIO20); also elsewhere on the board
SMC_DISP_MOSI: U6.30 (GPIO19); also elsewhere on the board
SMC_DISP_RST: U6.28 (GPIO17); also elsewhere on the board
SMC_DISP_SCK: U6.29 (GPIO18); also elsewhere on the board
SMC_I2C_SCL: R47.2, TP23.1, U6.35 (GPIO23); also elsewhere on the board
SMC_I2C_SDA: R46.2, TP22.1, U6.34 (GPIO22); also elsewhere on the board
SMC_INT: U6.3 (GPIO1); also elsewhere on the board
SMC_LED: D4.2 (A), TP34.1, U6.5 (GPIO3)
SMC_PI_I2C_SCL: U6.12 (GPIO9); also elsewhere on the board
SMC_PI_I2C_SDA: U6.11 (GPIO8); also elsewhere on the board
SMC_QSPI_SCLK: TP12.1, U5.6 (CLK), U6.52 (QSPI_SCLK)
SMC_QSPI_SD0: TP24.1, U5.5 (DI(IO0)), U6.53 (QSPI_SD0)
SMC_QSPI_SD1: TP25.1, U5.2 (DO(IO1)), U6.55 (QSPI_SD1)
SMC_QSPI_SD2: TP26.1, U5.3 (IO2), U6.54 (QSPI_SD2)
SMC_QSPI_SD3: TP27.1, U5.7 (IO3), U6.51 (QSPI_SD3)
SMC_RMT_RX: TP17.1, U6.16 (GPIO13); also elsewhere on the board
SMC_RMT_TX: TP16.1, U6.15 (GPIO12); also elsewhere on the board
SMC_RX_PI_TX: U6.7 (GPIO5); also elsewhere on the board
SMC_TX_PI_RX: U6.6 (GPIO4); also elsewhere on the board
SMC_USB_MUXED_D+: R16.1; also elsewhere on the board
SMC_USB_MUXED_D-: R17.1; also elsewhere on the board
USB_DET: U6.41 (GPIO29_ADC3); also elsewhere on the board
USB_MUX_SEL: U6.4 (GPIO2); also elsewhere on the board
~FG_ALRT: U6.39 (GPIO27_ADC1); also elsewhere on the board
~SMC_QSPI_SS: R12.2, R13.1, U5.1 (~CS), U6.56 (~QSPI_SS)

Notes on the sheet:
Pi contains its own resistor pullups, exxternal pullups only needed for SMC bus
Resistors must be close to DP and DM pins
Pi Zero W doesn't have RTS/CTS
SMC (System Management Controller)
I2C0 -> Pi
UART1 -> Pi
SPI1 -> Clickwheel
Testpoints
SMC Decoupling Caps
UART0 -> Remote
I2C Pullups
Pullup may be needed for other flash chips
It doesn't seem to be possible to operate as a SPI slave without ~{CS}
1uF caps MUST be near VREG_VIN and VREG_VOUT
SPI0 -> Display
SMC Flash
I2C1 -> Sensors

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
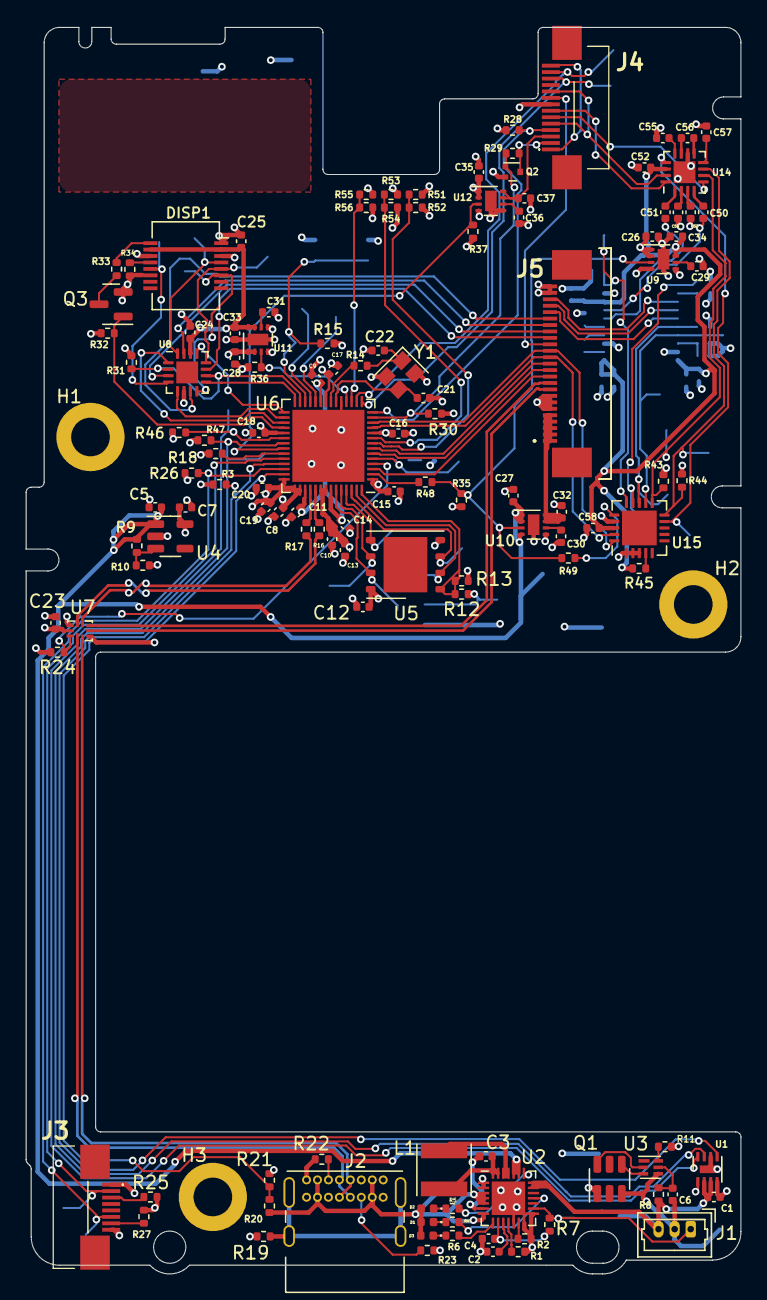
[picture p16: board pipod_hw.kicad_pcb from above]

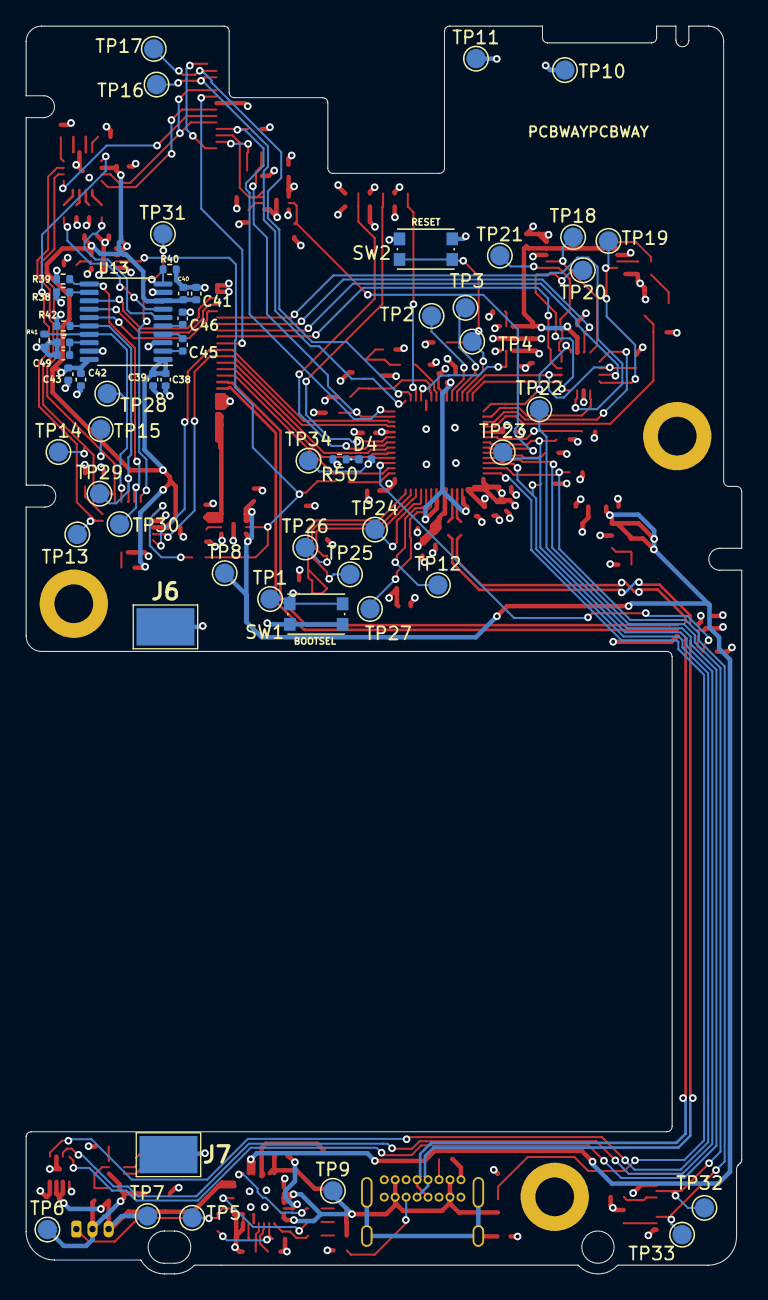
[picture p17: board pipod_hw.kicad_pcb from below]

Board: 4 copper layers, 55.5 x 96.8 mm, 184 parts (56 on the bottom side), 136 nets.
