Gigahawk/pipod_hw/pipod_compute.kicad_pcb

## KiCad design pipod_compute.kicad_pcb (2022-12-23)

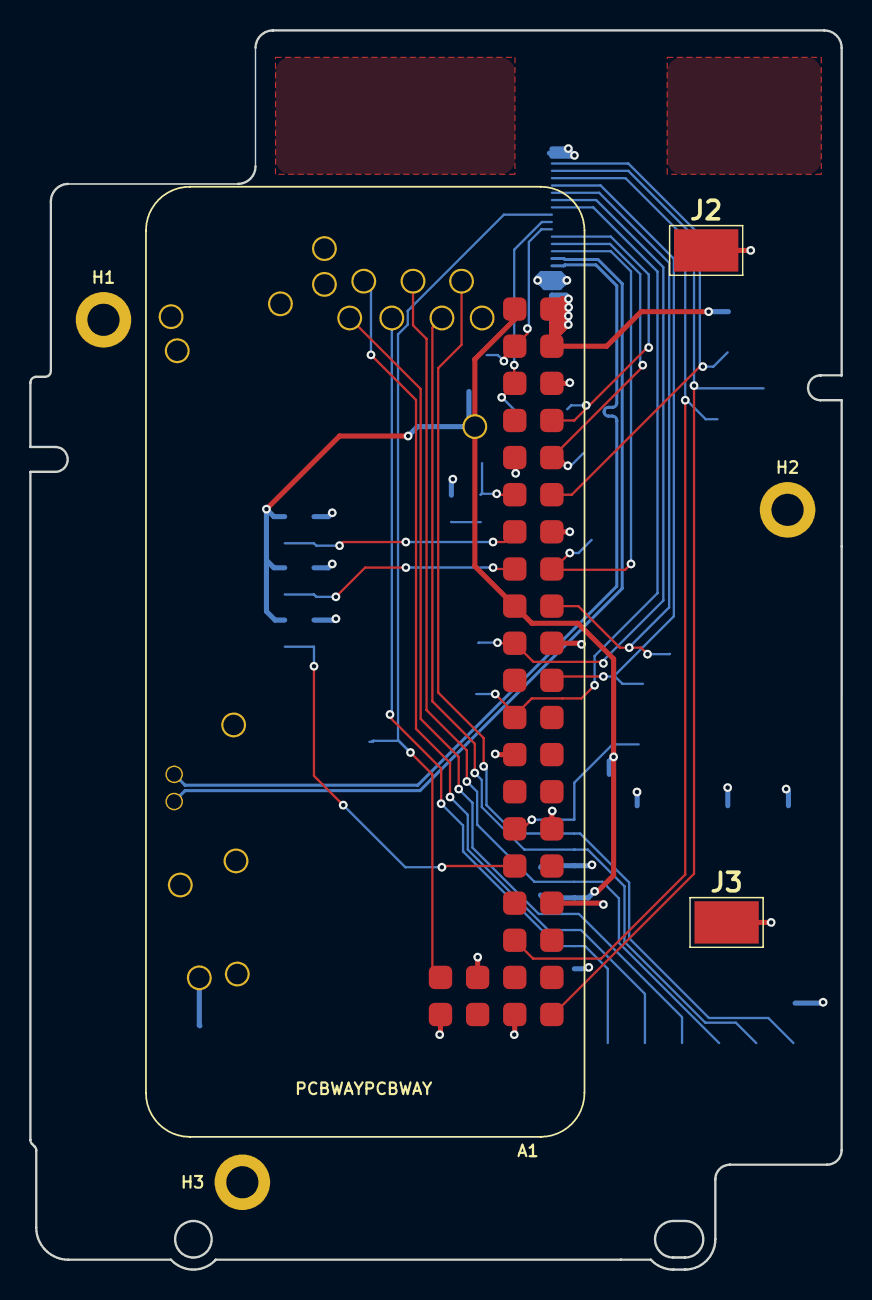
[picture p18: board pipod_compute.kicad_pcb from above]

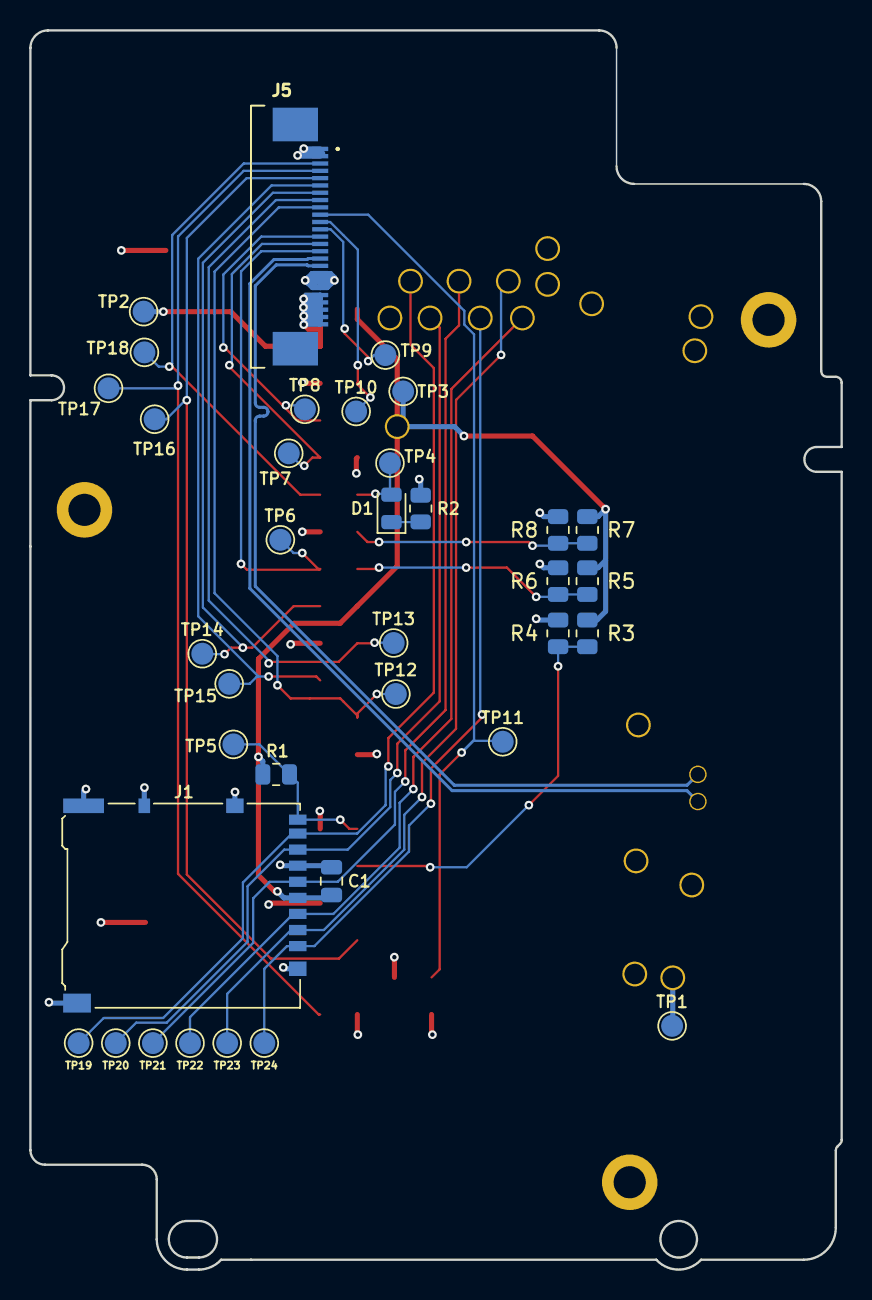
[picture p19: board pipod_compute.kicad_pcb from below]

Board: 4 copper layers, 55.5 x 84.8 mm, 43 parts (36 on the bottom side), 30 nets.

Parts:
A1: RASPBERRY_PI_ZERO_SMT; RASPI_ZERO_1_3_SMT_LOW_PROFILE
C1: 10u; C_0805_2012Metric
D1: GRN; LED_0805_2012Metric
H1, H2, H3: MountingHole_Pad; MountingHole_2.2mm_M2_DIN965_Pad
J1: Micro_SD_Card; microSD_HC_Hirose_DM3AT-SF-PEJM5
J2, J3: S7041-42R
J5: 2-1734839-5; 217348395
LOGO1: Logo_Open_Hardware_Large; OSHW-Logo2_9.8x8mm_Mask
R1, R4, R6, R8: 10k; R_0805_2012Metric
R2: 470R; R_0805_2012Metric
R3, R5, R7: DNI; R_0805_2012Metric
TP1, TP2, TP3, TP4, TP5, TP6, TP7, TP8, TP9, TP10, TP11, TP12, TP13, TP14, TP15, TP16, TP17, TP18, TP19, TP20, TP21, TP22, TP23, TP24: TestPoint; TestPoint_Pad_D1.5mm

Connections:
+3V3: A1.1 (3V3), A1.17 (3V3), A1.PP8 (3V3), C1.2, J1.4 (VDD), R1.2, R3.1, R5.1, R7.1, TP3.1
GND: A1.6 (GND), A1.9 (GND), A1.14 (GND), A1.20 (GND), A1.25 (GND), A1.30 (GND), A1.34 (GND), A1.39 (GND), A1.PP5 (GND), A1.PP6 (GND), A1.PP35 (GND), A1.RUN1 (GND), A1.TV2 (GND), C1.1, H1.1, H2.1, H3.1, J1.6 (VSS), J1.10 (DET_A), J1.11 (SHIELD), J2.1, J3.1, J5.1, J5.2, J5.18, J5.19, J5.20, R2.1, R4.2, R6.2, R8.2, TP1.1
HP_SL_VIDEO: A1.TV1 (TV), J5.10, TP11.1
HWID0: A1.31 (GPIO6), R3.2, R4.1
HWID1: A1.15 (GPIO22), R5.2, R6.1
HWID2: A1.13 (GPIO27), R7.2, R8.1
unnamed: A1.11 (GPIO17), D1.2 (A), TP4.1
unnamed: D1.1 (K), R2.2
PI_DISP_DC: A1.18 (GPIO24), J5.7, TP14.1
PI_DISP_MOSI: A1.19 (GPIO10/MOSI), J5.8, TP13.1
PI_DISP_RST: A1.22 (GPIO25), J5.6, TP15.1
PI_DISP_SCK: A1.23 (GPIO11/SCLK), J5.9, TP12.1
PI_I2S_BCK: A1.12 (GPIO18/PCM_CLK), J5.3, TP18.1
PI_I2S_DIN: A1.40 (GPIO21/PCM_DOUT), J5.4, TP17.1
PI_I2S_LRCK: A1.35 (GPIO19/PCM_FS), J5.5, TP16.1
PI_USB_MUXED_D+: A1.PP22 (USB_D+), J5.16
PI_USB_MUXED_D-: A1.PP23 (USB_D-), J5.17
SD_CD: A1.PP19 (SD_CD), J1.2 (DAT3/CD), TP23.1
SD_CLK: A1.PP14 (SD_CLK), J1.5 (CLK), TP21.1
SD_CMD: A1.PP15 (SD_CMD), J1.3 (CMD), TP22.1
SD_DAT0: A1.PP16 (SD_DAT0), J1.7 (DAT0), TP20.1
SD_DAT1: A1.PP17 (SD_DAT1), J1.8 (DAT1), TP19.1
SD_DAT2: A1.PP18 (SD_DAT2), J1.1 (DAT2), TP24.1
SD_DET: A1.29 (GPIO5), J1.9 (DET_B), R1.1, TP5.1
SMC_INT: A1.16 (GPIO23), J5.15, TP6.1
SMC_PI_I2C_SCL: A1.5 (GPIO3/SCL), J5.11, TP10.1
SMC_PI_I2C_SDA: A1.3 (GPIO2/SDA), J5.12, TP9.1
SMC_RX_PI_TX: A1.8 (GPIO14/TXD), J5.13, TP8.1
SMC_TX_PI_RX: A1.10 (GPIO15/RXD), J5.14, TP7.1
VCC: A1.2 (5V), A1.4 (5V), J5.21, J5.22, J5.23, J5.24, J5.25, TP2.1
