Gigahawk/pipod_hw/(commit log)

2022-08-23 layout: copy layout from clickwheel breakout
    [pipod_hw.kicad_pcb, pipod_hw.kicad_sch]
2022-08-25 drc: set DRC for JLCPCB
    [pipod_hw.kicad_pcb]
2022-08-25 schem: add LCSC lib, import DW01A
    [pipod_hw.kicad_sch]
2022-08-25 schem: add battery protection
    [pipod_hw.kicad_sch]
2022-08-30 analysis: determine TEMP resistors
2022-08-30 schem: add battery charging, charger isolation
    [pipod_hw.kicad_sch, power.kicad_sch]
2022-08-31 analysis: determine LDO resistors
2022-08-31 schem: finish power design, start SMC design
    [pipod_hw.kicad_sch, power.kicad_sch]
2022-09-06 analysis: add documentation on load switches
2022-09-06 schem: digital design first pass
    [clickwheel.kicad_sch, display.kicad_sch, headphone.kicad_sch, load_switches.kicad_sch, pipod_hw.kicad_sch, power.kicad_sch, smc.kicad_sch, usb.kicad_sch]
2022-09-07 schem: first pass done, ERC passing
    [audio.kicad_sch, clickwheel.kicad_sch, display.kicad_sch, headphone.kicad_sch, load_switches.kicad_sch, pi.kicad_sch, pipod_hw.kicad_sch, power.kicad_sch]
2022-09-27 analysis: specify pi will be powered directly from VCC
    [audio.kicad_sch, clickwheel.kicad_sch, display.kicad_sch, headphone.kicad_sch, load_switches.kicad_sch, pi.kicad_sch, pipod_hw.kicad_pcb, pipod_hw.kicad_sch]
2022-09-27 analysis: change system regulator to one with lower dropout
    [load_switches.kicad_sch, pipod_hw.kicad_sch, power.kicad_sch, smc.kicad_sch, usb.kicad_sch]
2022-09-30 schem: add MOSFET to drive clickwheel
    [headphone.kicad_sch, pipod_hw.kicad_sch, power.kicad_sch, usb.kicad_sch]
2022-09-30 analysis: discuss mounting hardware
2022-09-30 layout: switch to lcsc fpc connectors
    [clickwheel.kicad_sch, headphone.kicad_sch, pipod_hw.kicad_pcb, pipod_hw.kicad_sch]
2022-10-03 integration: add mounting holes and connectors and second board
    [clickwheel.kicad_sch, headphone.kicad_sch, pi.kicad_sch, pipod_compute.kicad_pcb, pipod_compute.kicad_sch, pipod_hw.kicad_pcb, pipod_hw.kicad_sch]
2022-10-04 schem: migrate away from LCSC exclusive parts
    - layout: migrate away from lcsc footprints
    [audio.kicad_sch, clickwheel.kicad_sch, display.kicad_sch, headphone.kicad_sch, load_switches.kicad_sch, pi.kicad_sch, pipod_compute.kicad_pcb, pipod_hw.kicad_pcb]
2022-10-05 layout: update footprint for TP4056M
    [audio.kicad_sch, clickwheel.kicad_sch, display.kicad_sch, headphone.kicad_sch, load_switches.kicad_sch, pi.kicad_sch, pipod_hw.kicad_pcb, pipod_hw.kicad_sch]
2022-10-17 analysis: add calculation for battery protection
2022-10-17 analysis: remove thermistor calculations, switched to MAX8903
2022-10-17 analysis: add 0.2mm gap calculation for usb impedance
2022-10-18 layout: preliminary layout of most of board
    [audio.kicad_sch, clickwheel.kicad_sch, display.kicad_sch, headphone.kicad_sch, load_switches.kicad_sch, pi.kicad_sch, pipod_hw.kicad_pcb, pipod_hw.kicad_sch]
2022-11-07 routing: begin routing
    [audio.kicad_sch, display.kicad_sch, pi.kicad_sch, pipod_hw.kicad_pcb, pipod_hw.kicad_sch, smc.kicad_sch]
2022-11-08 routing: finish routing (board is not manufacturable)
    [pi.kicad_sch, pipod_hw.kicad_pcb]
2022-11-09 analysis: add usb impedance calc for 0.16mm track spacing
2022-11-09 layout, routing: relayout and reroute board
    [audio.kicad_sch, clickwheel.kicad_sch, display.kicad_sch, headphone.kicad_sch, load_switches.kicad_sch, pi.kicad_sch, pipod_hw.kicad_pcb, pipod_hw.kicad_sch]
2022-11-10 layout: add testpoints, extra mounting hole, grounding clips
    [audio.kicad_sch, clickwheel.kicad_sch, display.kicad_sch, headphone.kicad_sch, load_switches.kicad_sch, pi.kicad_sch, pipod_hw.kicad_pcb, pipod_hw.kicad_sch]
2022-11-17 layout: cleanup silkscreen, add bootloader buttons
    [pipod_compute.kicad_pcb, pipod_compute.kicad_sch, pipod_hw.kicad_pcb, pipod_hw.kicad_sch, power.kicad_sch, smc.kicad_sch]
2022-11-18 analysis: add notes on allowing pi to latch its own power
2022-11-18 schematic: add resistors to allow latching pi power
    [load_switches.kicad_sch, pi.kicad_sch, pipod_hw.kicad_pcb, pipod_hw.kicad_sch, smc.kicad_sch]
2022-11-22 compute: finish layout and routing
    [pi.kicad_sch, pipod_compute.kicad_pcb, pipod_compute.kicad_sch, pipod_hw.kicad_pcb, pipod_hw.kicad_sch, smc.kicad_sch]
2022-11-24 ci: prepare files for CI
    [audio.kicad_sch, clickwheel.kicad_sch, display.kicad_sch, headphone.kicad_sch, load_switches.kicad_sch, pi.kicad_sch, pipod_compute.kicad_pcb, pipod_compute.kicad_sch]
2022-11-24 compute: update constraints to match cheaper pcbway tier
    [pipod_compute.kicad_pcb]
2022-11-24 smc: update constraints to match cheaper pcbway tier
    [pipod_hw.kicad_pcb]
2022-11-24 ci: count SMD and THT parts in BOM
2022-11-24 ci: export footprint type and side in bom
2022-11-24 ci: enable pcb and stats info in BOM
2022-11-24 ci: add footprint populate column to BOM
2022-11-25 ci: add vendor/distributor part numbers to bom
    [smc.kicad_sch]
2022-11-25 ci: enable bom quantity
2022-11-25 ci: rename jlcpcb outputs to pcbway, enable boardview output
2022-11-25 layout: add OSHW logo, change version text to masked copper
    [pipod_compute.kicad_pcb, pipod_compute.kicad_sch, pipod_hw.kicad_pcb, pipod_hw.kicad_sch]
2022-11-25 compute: fill out bom columns
    [pipod_compute.kicad_pcb, pipod_compute.kicad_sch]
2022-12-23 feature: add hardware ID resistors
    [pipod_compute.kicad_pcb, pipod_compute.kicad_sch, pipod_hw.kicad_pcb, pipod_hw.kicad_sch, smc.kicad_sch]
